Eliiiiiiiiiiii/Growlight-controller/Controller.pdf

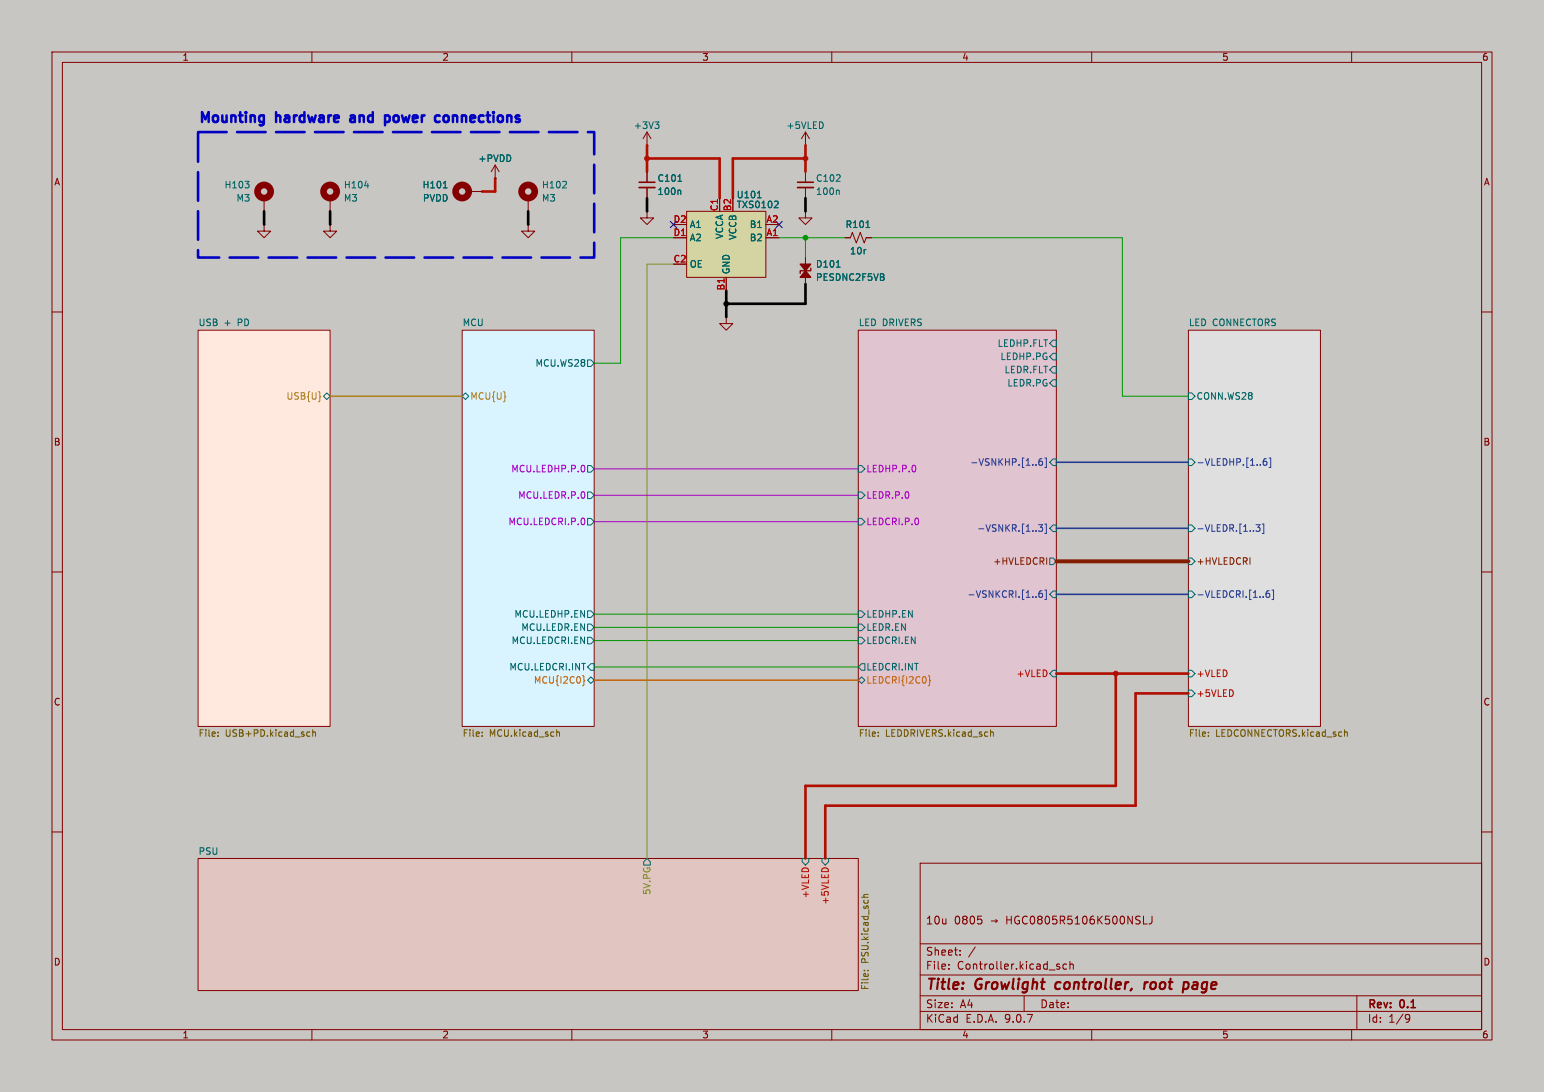
[picture p1: page 1]

100n H101 PVDD Mounting hardware and power connections

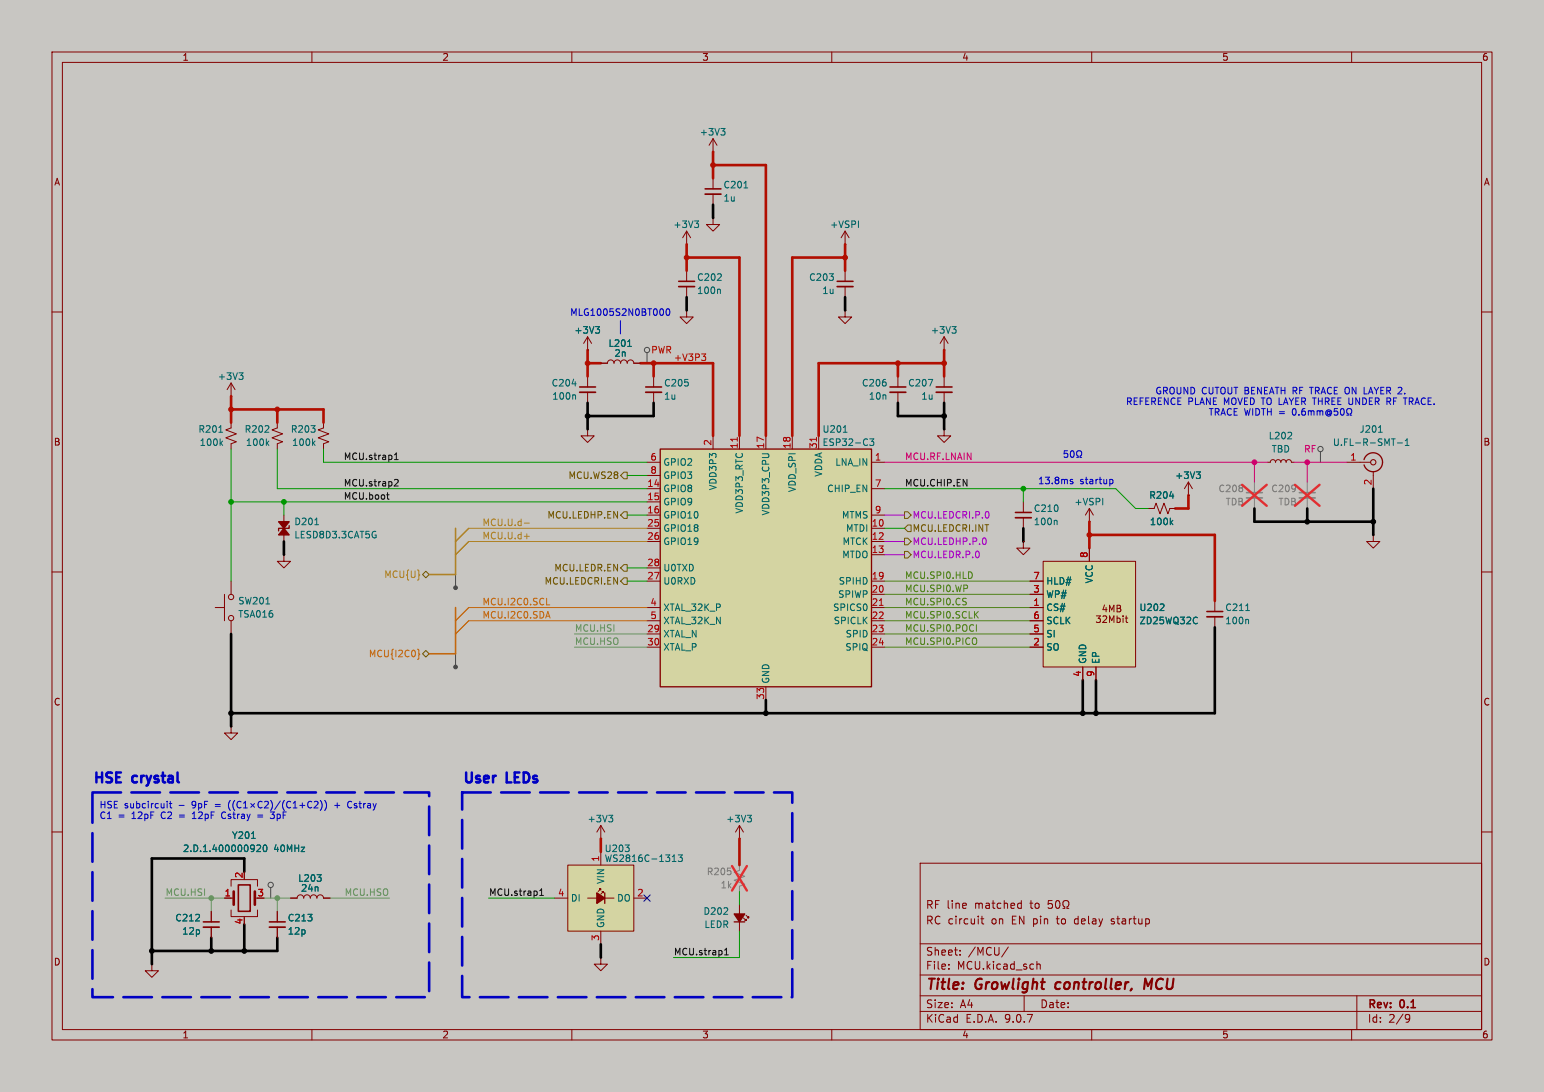
[picture p2: page 2]

8 HLD# 7 WP# 3 SI 5 SO 2 EP

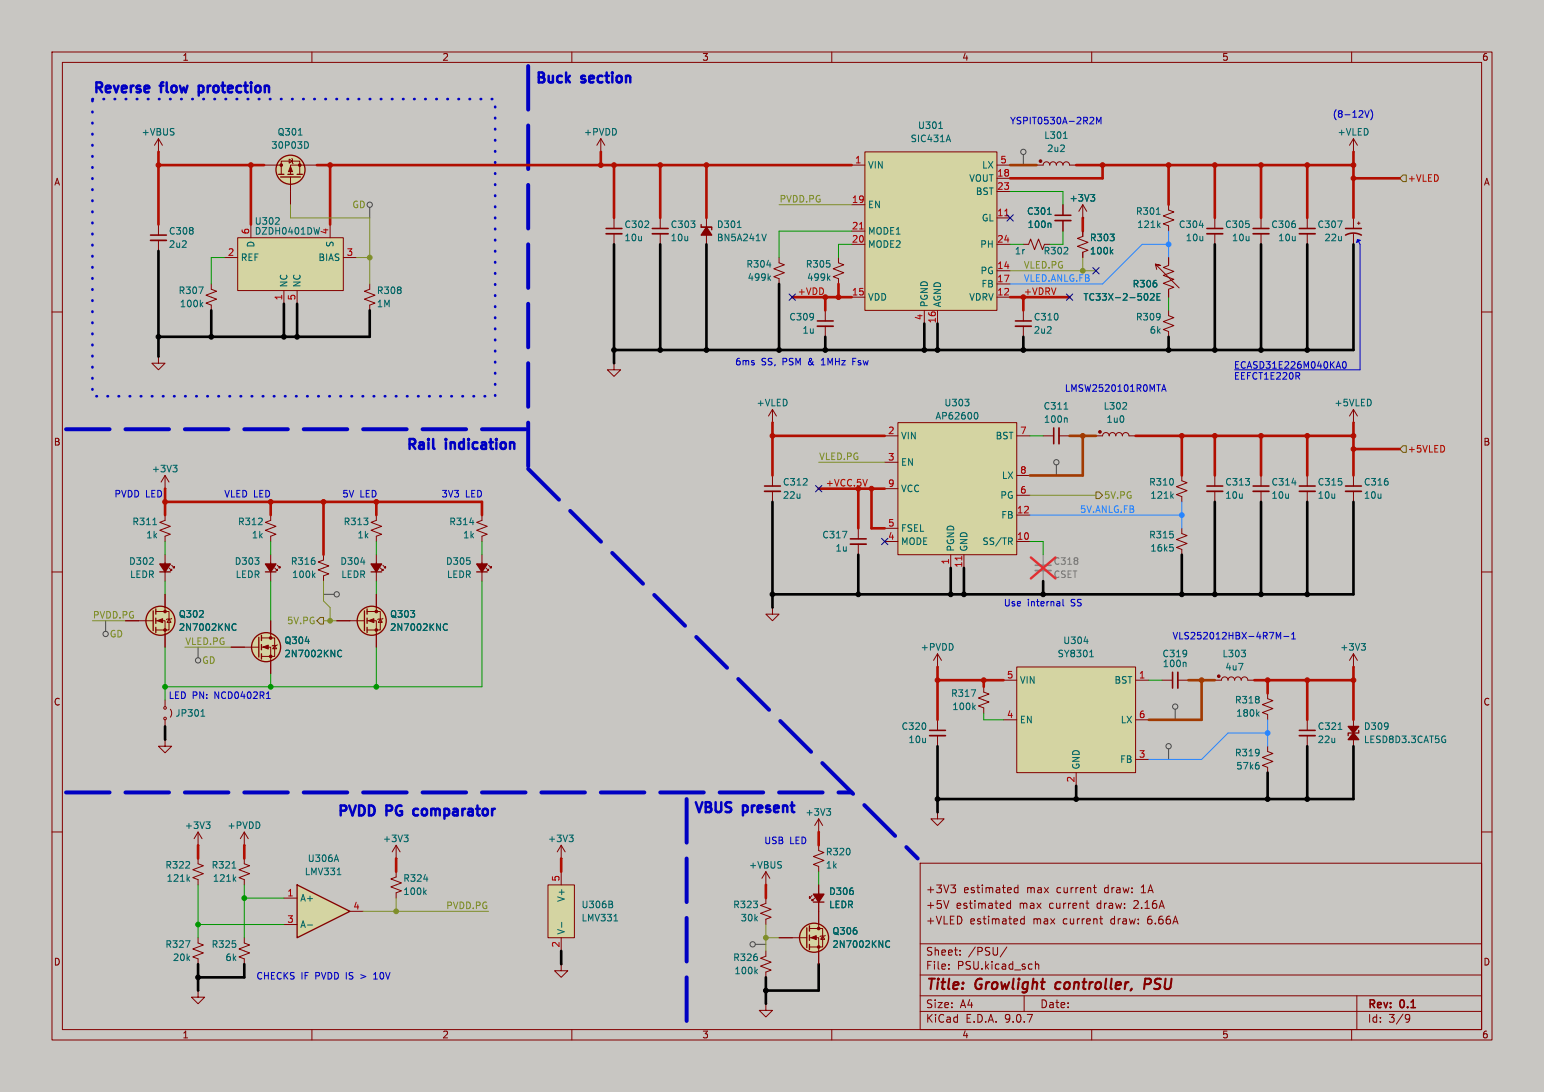
[picture p3: page 3]

LX 5 VOUT 18 BST 23 GL 11 PH 24 PG 14 FB 17 VDRV 12 U301 SIC431A R305

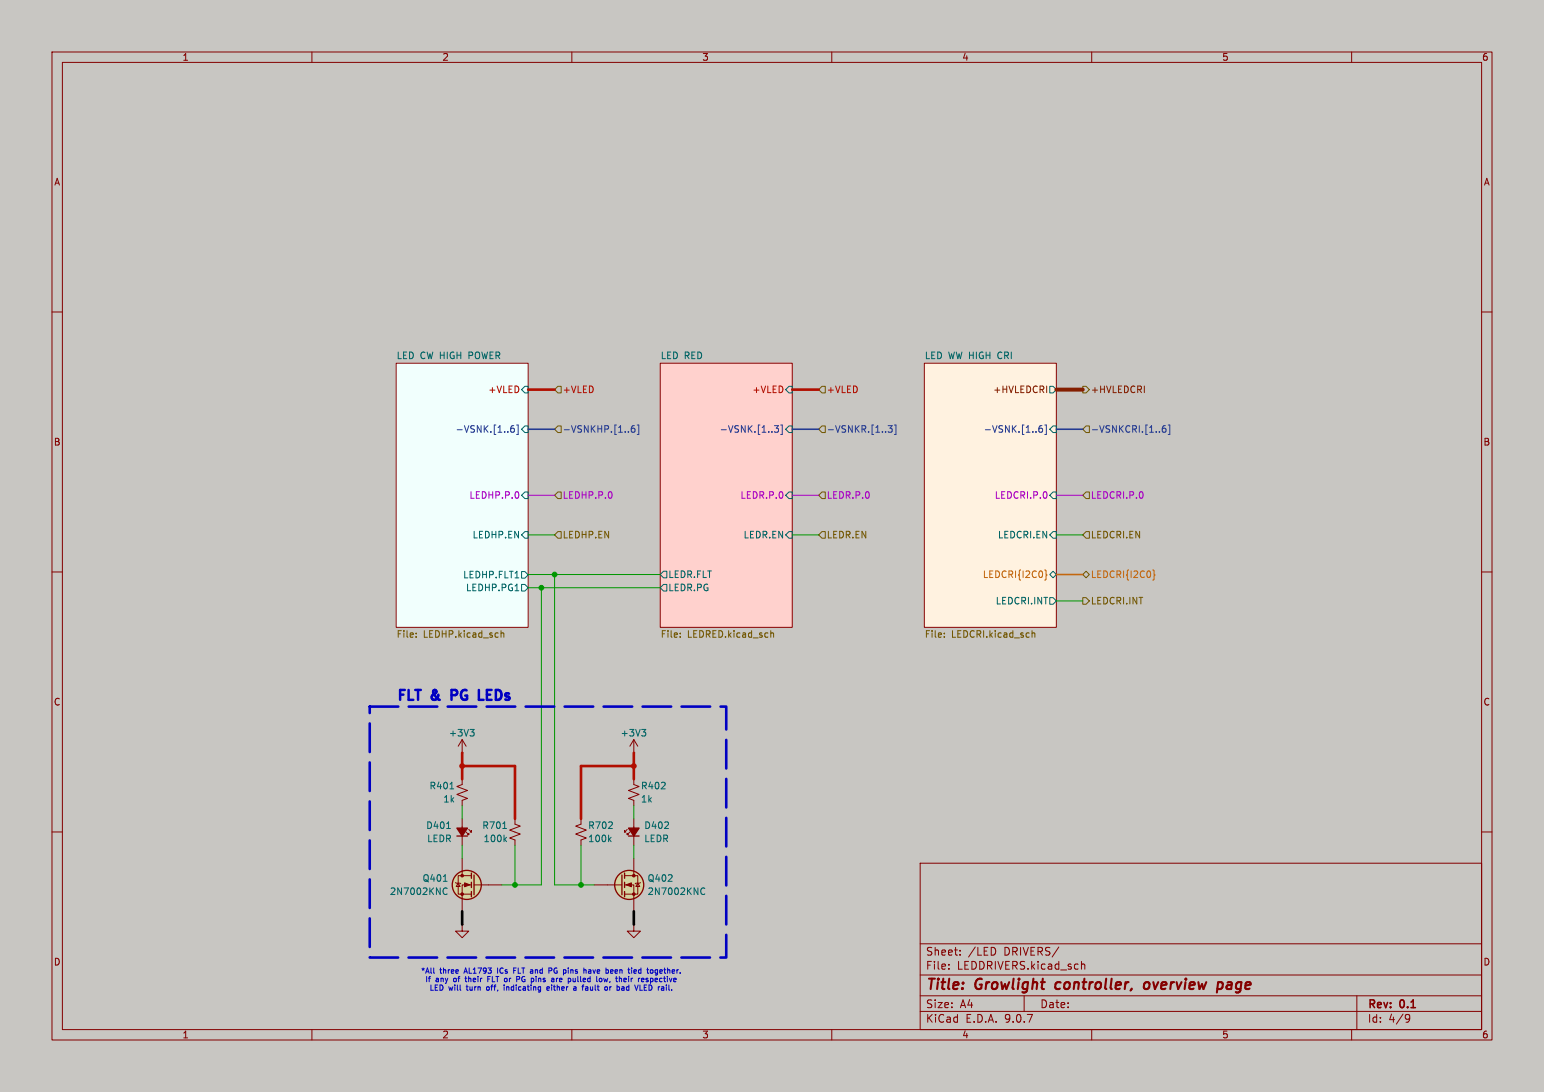
[picture p4: page 4]

LED CW HIGH POWER

LED WW HIGH CRI File: LEDCRI.kicad_sch R701

LEDCRI{I2C0} +HVLEDCRI -VSNK.[1..6] LEDCRI.P.0

*All three AL1793 ICs FLT and PG pins have been tied together.
If any of their FLT or PG pins are pulled low, their respective

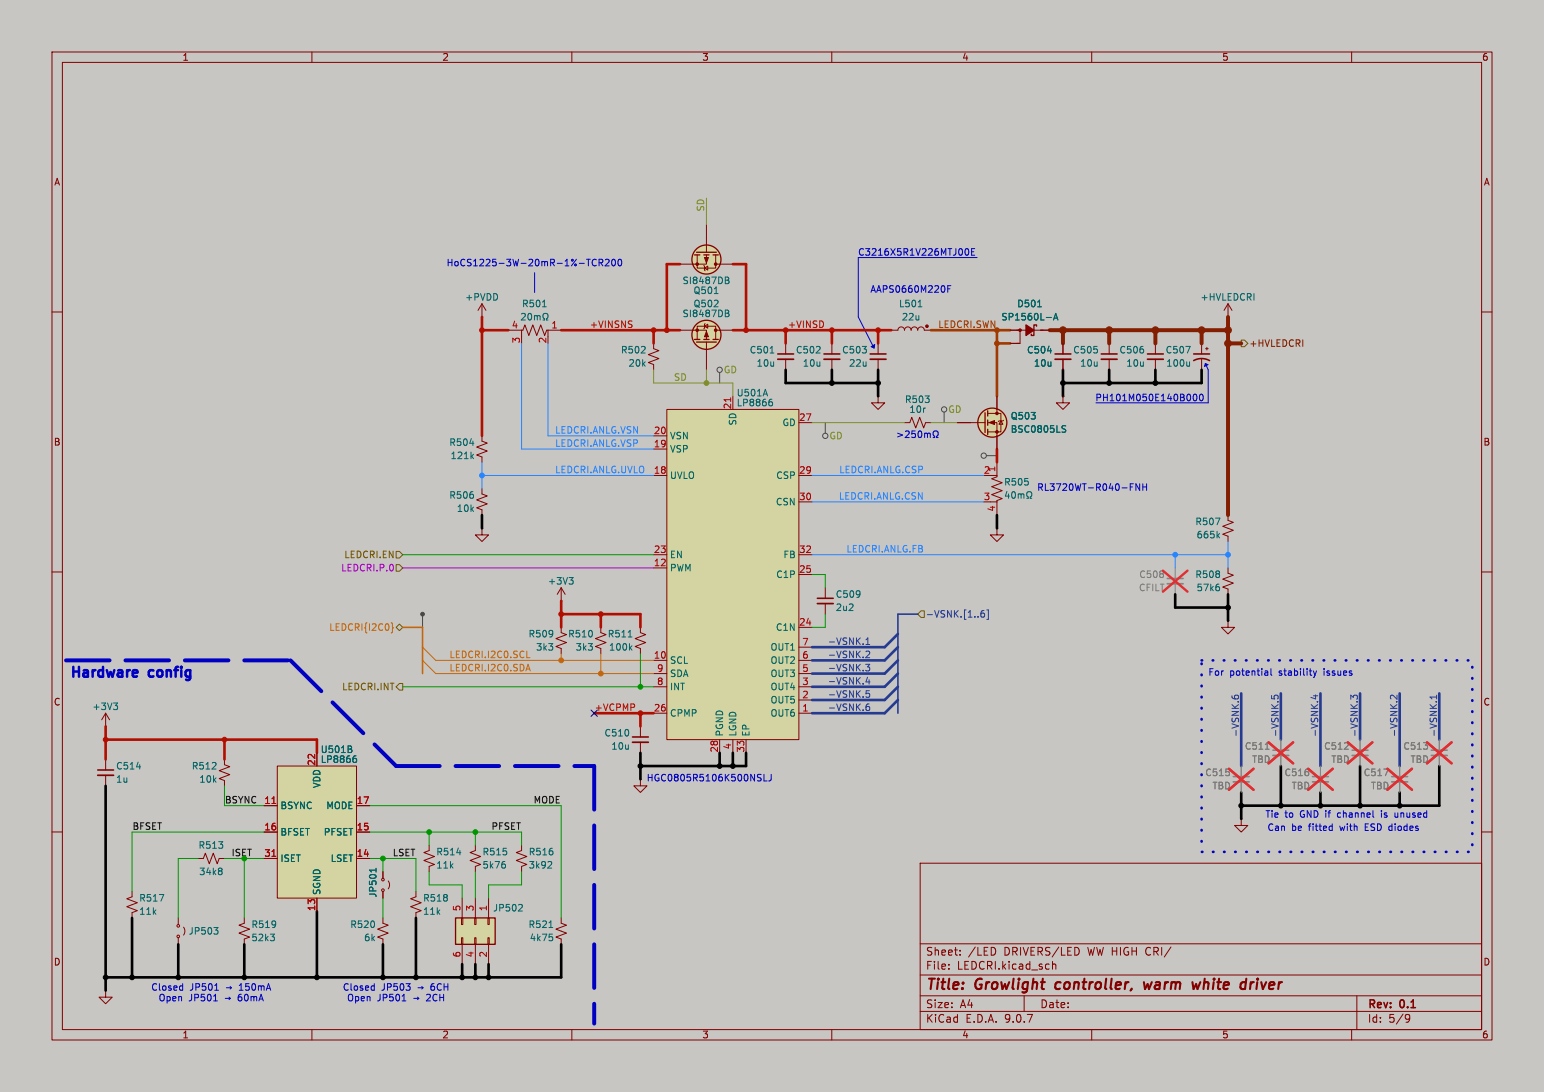
[picture p5: page 5]

4 EP 33 GD 27 CSP 29 CSN 30 FB 32 C1P 25 C1N 24 OUT1 7 OUT2 6 OUT3 5 OUT4 3 OUT5 2 OUT6 1 U501A

Closed JP501 þÿ!’150mA Open JP501 þÿ!’60mA Hardware config

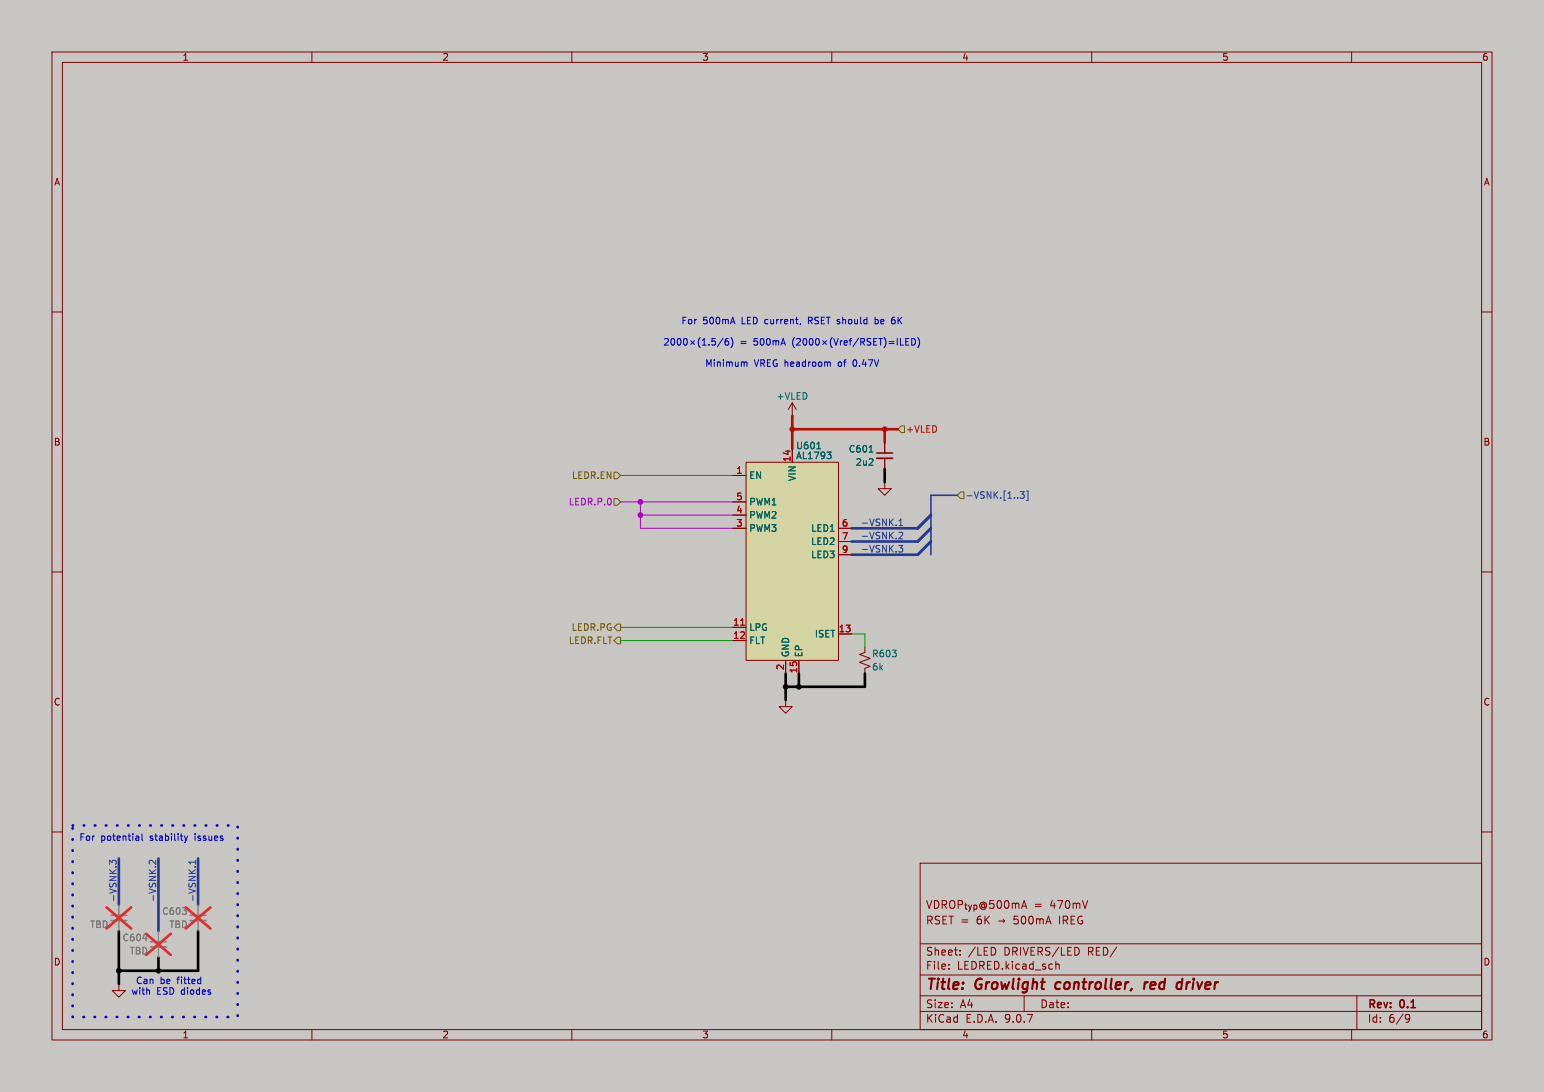
[picture p6: page 6]

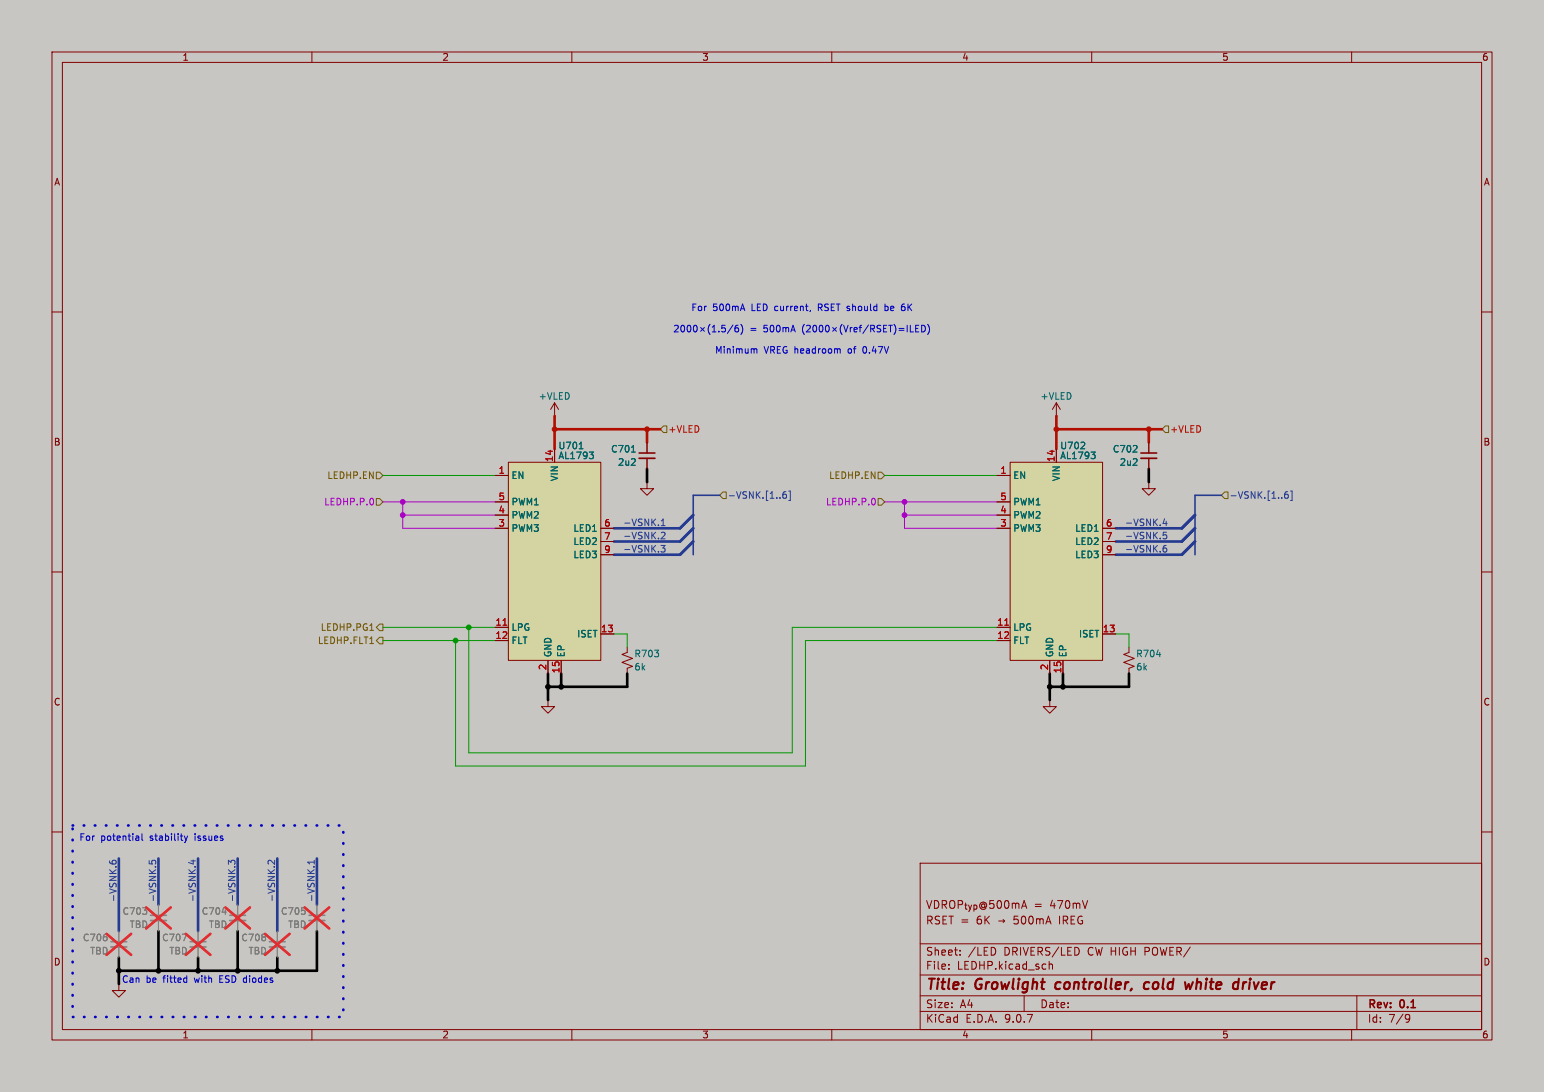
[picture p7: page 7]

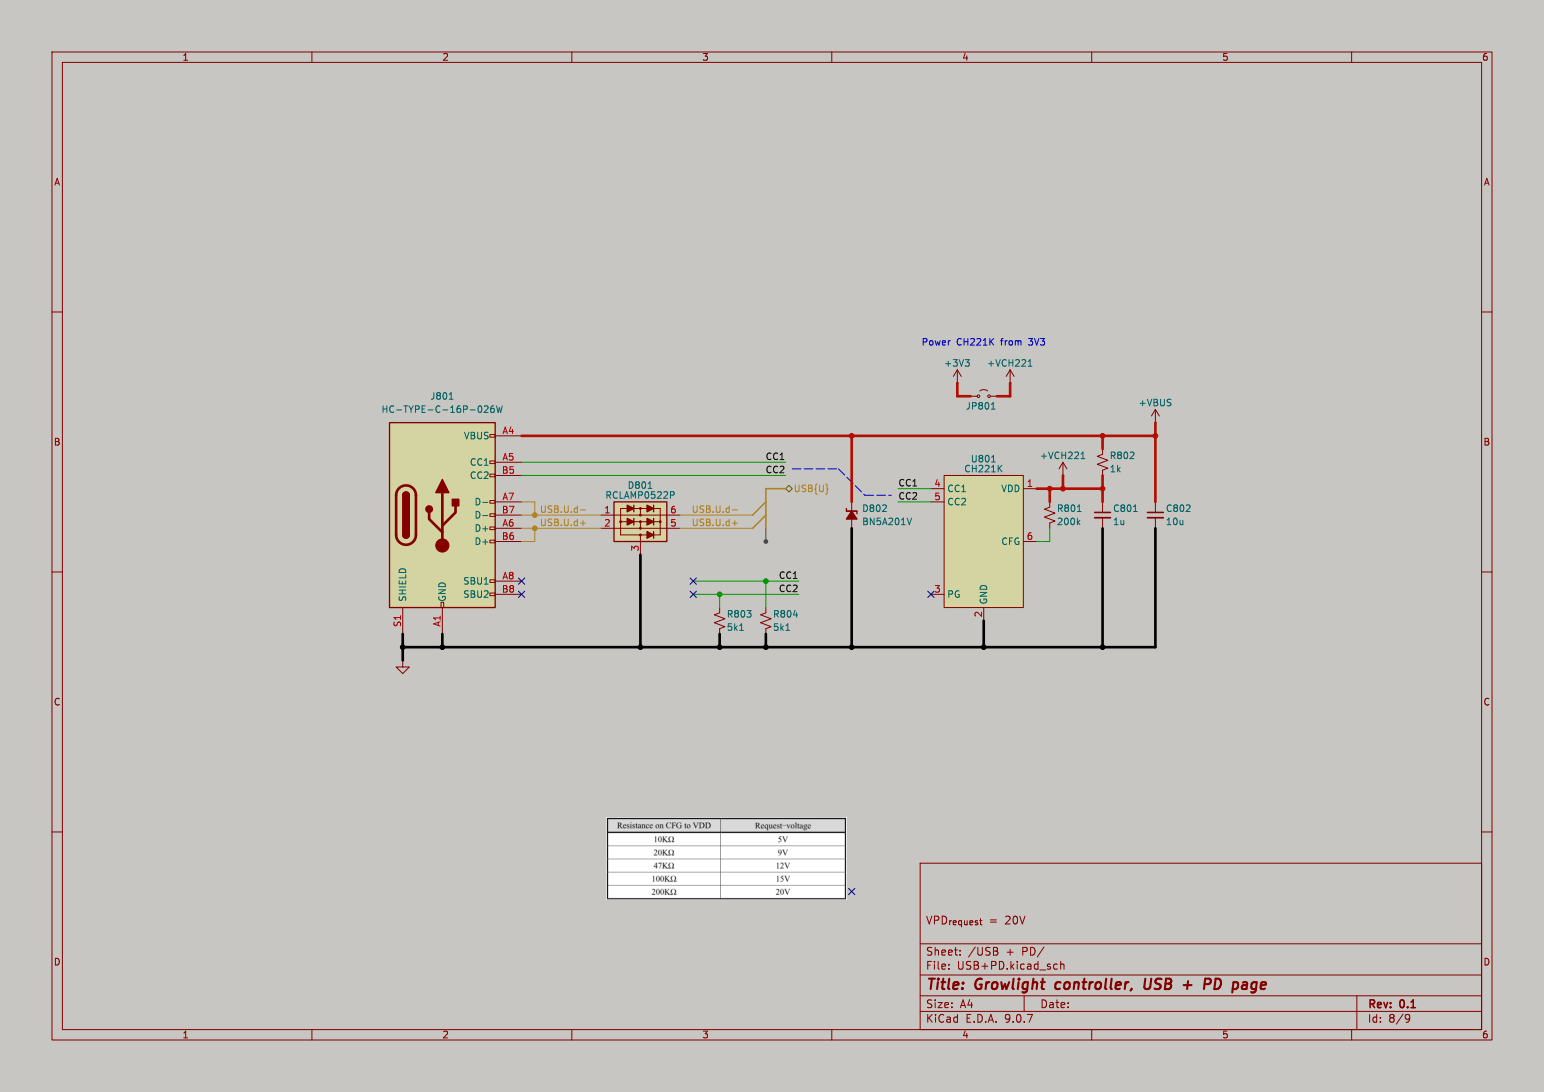
[picture p8: page 8]

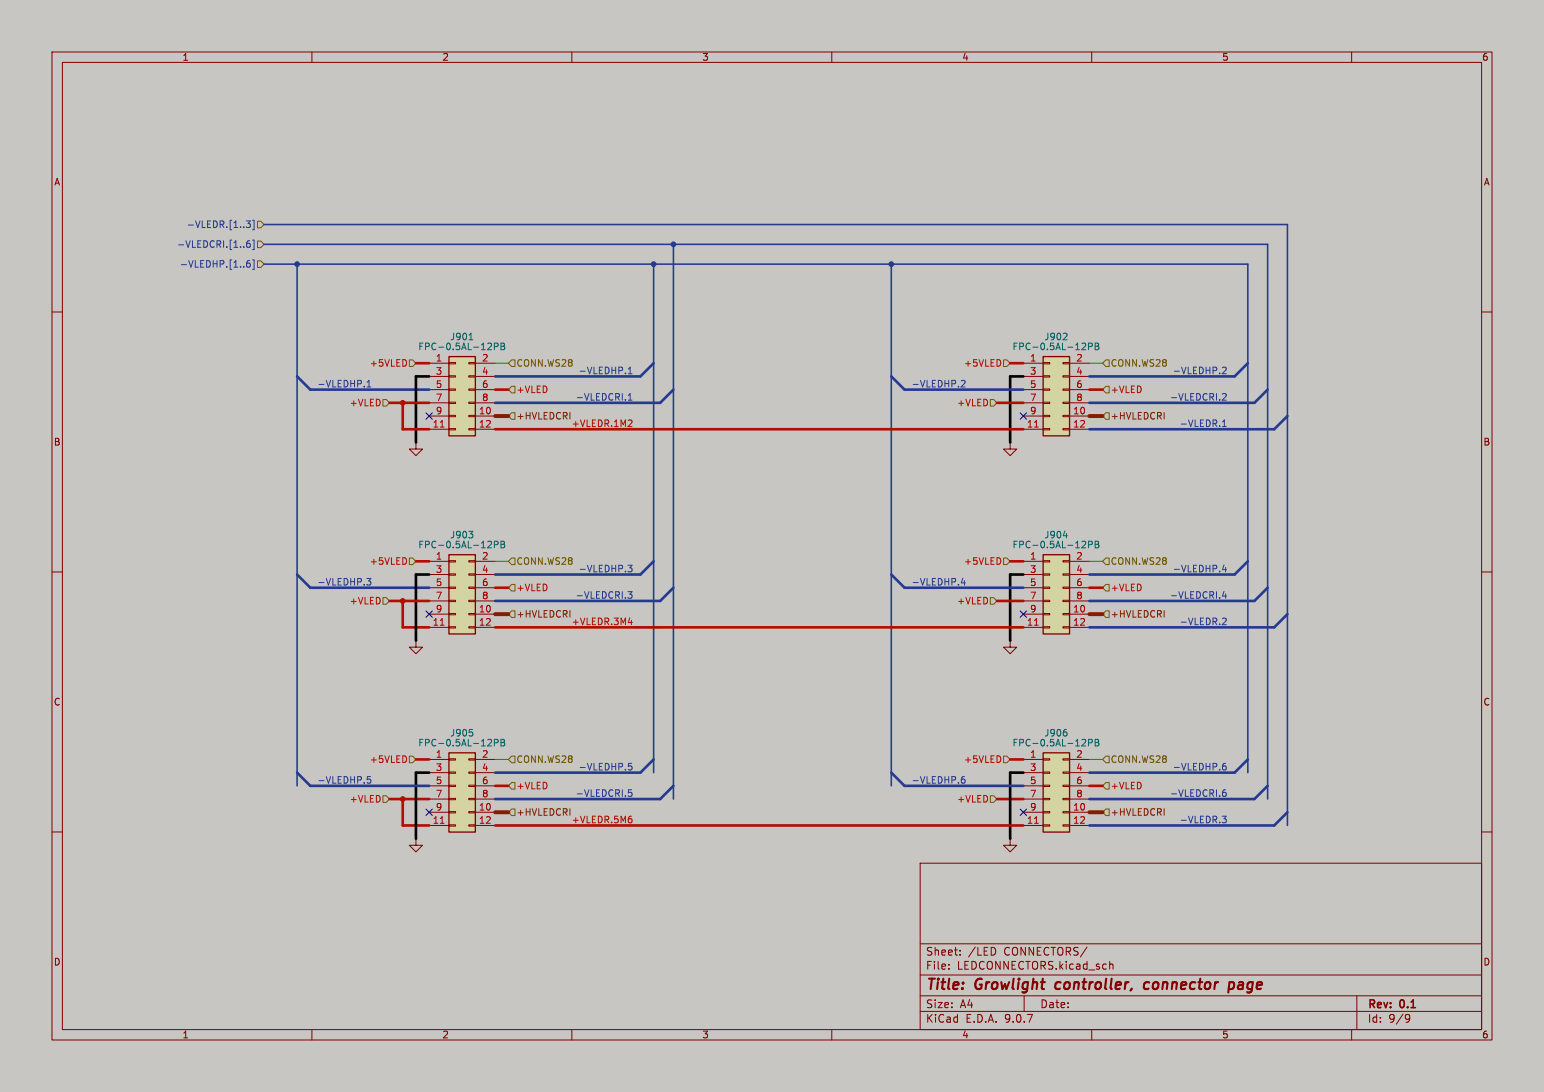
[picture p9: page 9]

File: LEDCONNECTORS.kicad_sch Sheet: /LED CONNECTORS/ 1
