Eliiiiiiiiiiii/Growlight-controller/Controller.kicad_pcb

## KiCad design Controller.kicad_pcb (2026-03-26)

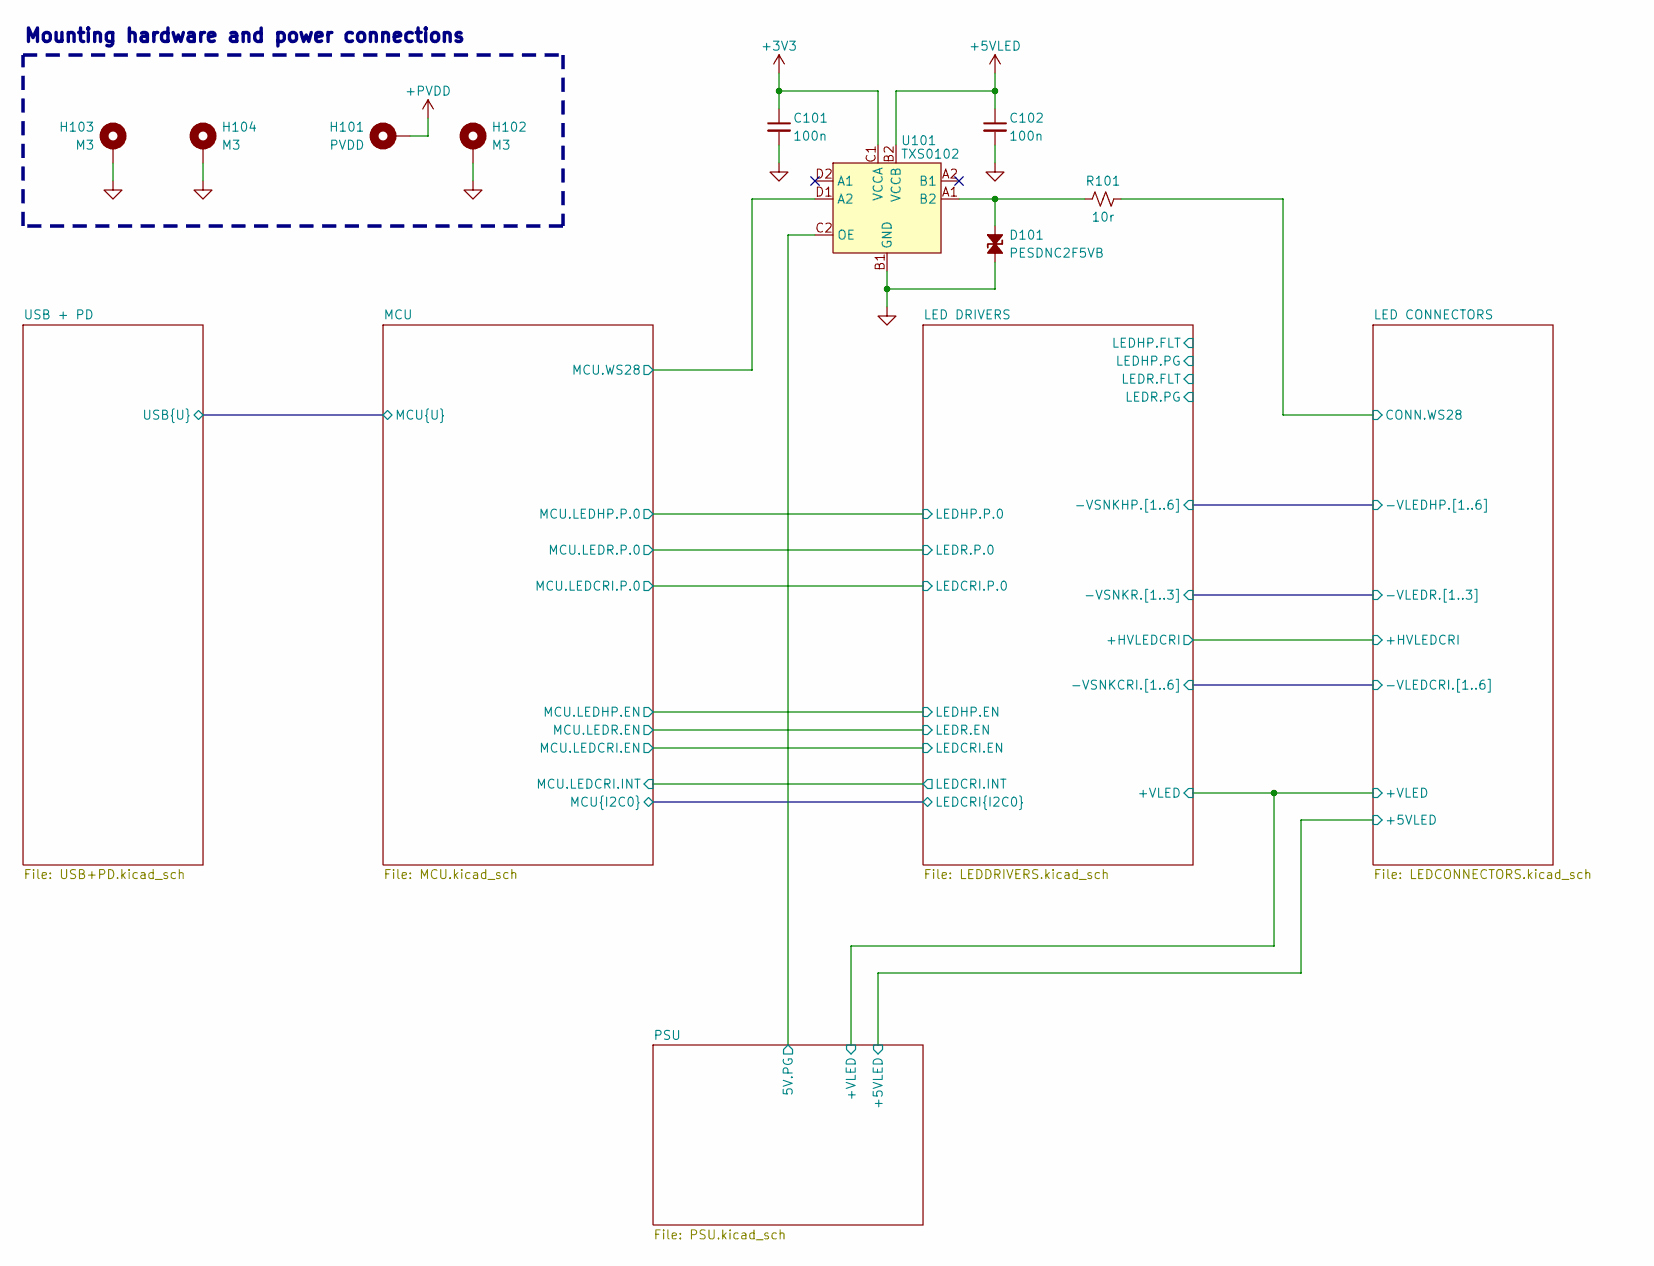
[picture p10: schematic Controller.kicad_sch, Growlight controller, root page]

Parts:
C101, C102: 100n; C 0402 (1005 Metric)
D101: PESDNC2F5VB; DFN-1006-2L
H101: PVDD; SMTSO3015CTJ
H102, H103, H104: M3; SMTSO3015CTJ
R101: 10r; R 0402 (1005 Metric)
U101: TXS0102; DSBGA-8 (0.9x1.9) P0.5

Connections:
+3V3: C101.1, U101.C1 (VCCA); also elsewhere on the board
+5VLED: C102.1, U101.B2 (VCCB); also elsewhere on the board
+PVDD: H101.1 (1_1); also elsewhere on the board
/LED CONNECTORS/CONN.WS28: R101.2; also elsewhere on the board
/MCU/MCU.WS28: U101.D1 (A2); also elsewhere on the board
/PSU/5V.PG: U101.C2 (OE); also elsewhere on the board
GND: C101.2, C102.2, D101.2 (A2), H102.1 (1_1), H103.1 (1_1), H104.1 (1_1), U101.B1 (GND); also elsewhere on the board
unnamed: D101.1 (A1), R101.1, U101.A1 (B2)

Notes on the sheet:
Mounting hardware and power connections

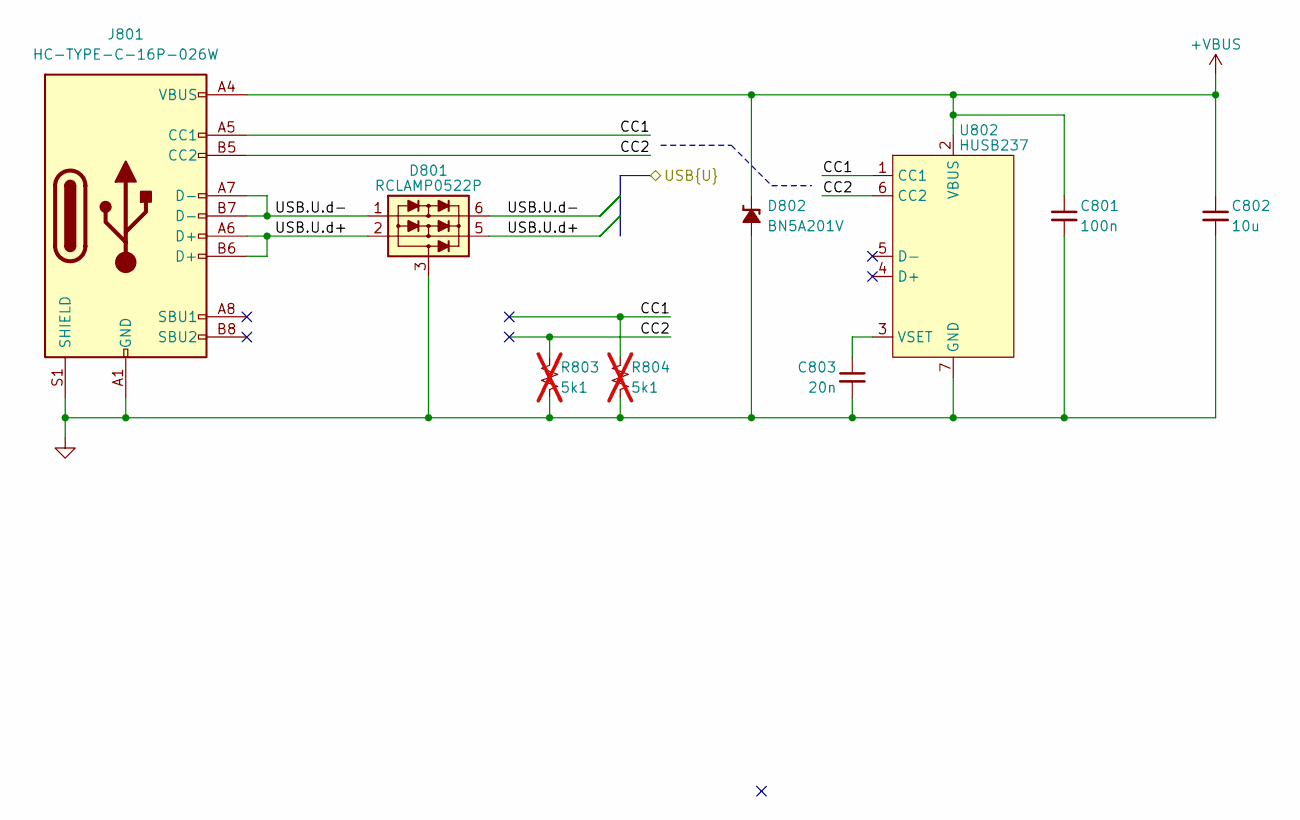
[picture p11: schematic USB+PD.kicad_sch, Growlight controller, USB + PD page]

Parts:
C801: 100n; C 0402 (1005 Metric)
C802: 10u; C 0805 (2012 Metric)
C803: 20n; C 0402 (1005 Metric)
D801: RCLAMP0522P; DFN1610-6L (1.6x1)
D802: BN5A201V; DFN1610-2L (1.6x1)
J801: HC-TYPE-C-16P-026W
R803, R804: 5k1; R 0402 (1005 Metric); not fitted
U802: HUSB237; SON-6 (2x2) P0.65

Connections:
+VBUS: C801.1, C802.1, D802.1 (K), J801.A4 (VBUS), J801.A9 (VBUS), J801.B4 (VBUS), J801.B9 (VBUS), U802.2 (VBUS); also elsewhere on the board
/MCU/MCU.U.d+: D801.2, D801.5, J801.A6 (D+), J801.B6 (D+); also elsewhere on the board
/MCU/MCU.U.d-: D801.1, D801.6, J801.A7 (D-), J801.B7 (D-); also elsewhere on the board
/USB + PD/CC1: J801.A5 (CC1), R804.1, U802.1 (CC1)
/USB + PD/CC2: J801.B5 (CC2), R803.1, U802.6 (CC2)
GND: C801.2, C802.2, C803.2, D801.3, D801.4, D802.2 (A), J801.A1 (GND), J801.A12 (GND), J801.B1 (GND), J801.B12 (GND), J801.S1 (SHIELD), R803.2, R804.2, U802.7 (GND); also elsewhere on the board
unnamed: C803.1, U802.3 (VSET)

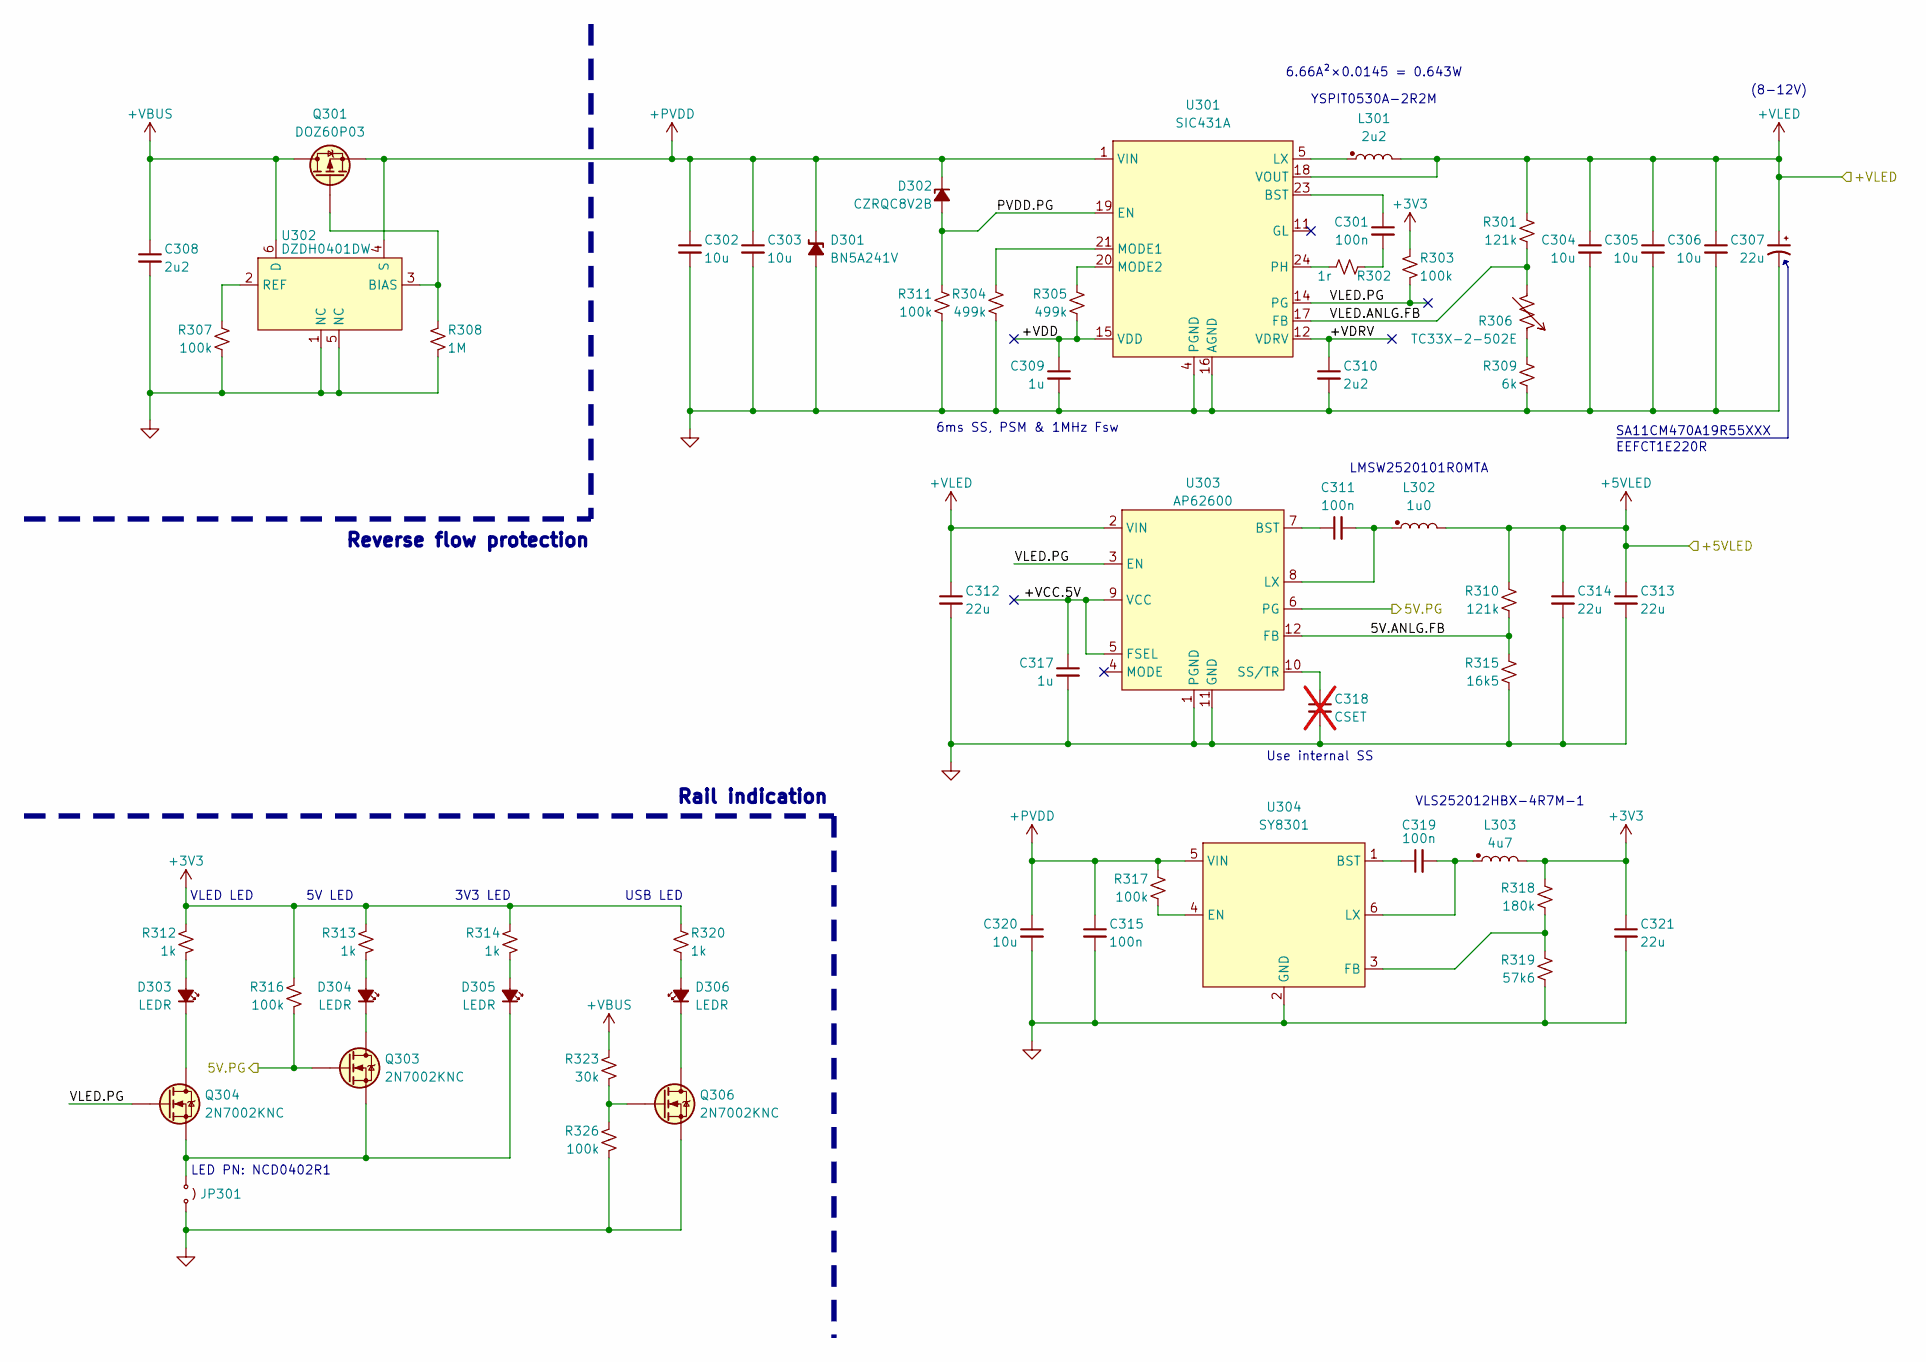
[picture p12: schematic PSU.kicad_sch, Growlight controller, PSU]

Parts:
C301, C311, C315, C319: 100n; C 0402 (1005 Metric)
C302, C303, C304, C305, C306, C320: 10u; C 0805 (2012 Metric)
C307: 22u; CP Flat (7.3x4.3) H1.4 muRata
C308, C310: 2u2; C 0603 (1608 Metric)
C309, C317: 1u; C 0402 (1005 Metric)
C312, C313, C314, C321: 22u; C 0805 (2012 Metric)
C318: CSET; C 0402 (1005 Metric); not fitted
D301: BN5A241V; DFN1610-2L (1.6x1)
D302: CZRQC8V2B; DFN-1006-2L
D303, D304, D305, D306: LEDR; LED-0402-R
JP301: Jumper_2_Small_Open; Jumper-NO 2P (1.9x1.4)
L301: 2u2; YSPIT0530A
L302: 1u0; LMSW252010
L303: 4u7; VLS252012
Q301: DOZ60P03; DFN-8 (3x3) 1EP
Q303, Q304, Q306: 2N7002KNC; DFN-1006-3L
R301, R310: 121k; R 0402 (1005 Metric)
R302: 1r; R 0402 (1005 Metric)
R303, R307, R311, R316, R317, R326: 100k; R 0402 (1005 Metric)
R304, R305: 499k; R 0402 (1005 Metric)
R306: TC33X-2-502E; TC33X-x-xxxx
R308: 1M; R 0402 (1005 Metric)
R309: 6k; R 0402 (1005 Metric)
R312, R313, R314, R320: 1k; R 0402 (1005 Metric)
R315: 16k5; R 0402 (1005 Metric)
R318: 180k; R 0402 (1005 Metric)
R319: 57k6; R 0402 (1005 Metric)
R323: 30k; R 0402 (1005 Metric)
U301: SIC431A; MLP44-24L (4x4) P0.45 Vishay
U302: DZDH0401DW; SOT-363
U303: AP62600; VQFN2030-12 (2x3) P0.5 DIODES
U304: SY8301; SOT-23-6

Connections:
+3V3: C321.1, L303.2, R303.1, R312.2, R313.2, R314.2, R316.2, R318.1, R320.2; also elsewhere on the board
+5VLED: C313.1, C314.1, L302.2, R310.1; also elsewhere on the board
+PVDD: C302.1, C303.1, C315.1, C320.1, D301.1 (K), D302.1 (K), Q301.1 (S), Q301.2 (S), Q301.3 (S), R317.1, U301.1 (VIN), U301.2 (VIN), U301.22 (VIN), U301.26 (VIN), U302.4 (S), U304.5 (VIN); also elsewhere on the board
+VBUS: C308.1, Q301.5 (D), R323.2, U302.6 (D); also elsewhere on the board
+VLED: C304.1, C305.1, C306.1, C307.1, C312.1, L301.2, R301.1, U301.18 (VOUT), U303.2 (VIN); also elsewhere on the board
/PSU/5V.ANLG.FB: R310.2, R315.1, U303.12 (FB)
/PSU/5V.PG: Q303.1 (G), R316.1, U303.6 (PG); also elsewhere on the board
/PSU/+VCC.5V: C317.1, U303.5 (FSEL), U303.9 (VCC)
/PSU/+VDD: C309.1, R305.2, U301.15 (VDD)
/PSU/+VDRV: C310.1, U301.12 (VDRV)
/PSU/PVDD.PG: D302.2 (A), R311.1, U301.19 (EN)
/PSU/VLED.ANLG.FB: R301.2, R306.2, U301.17 (FB)
/PSU/VLED.PG: Q304.1 (G), R303.2, U301.14 (PG), U303.3 (EN)
GND: C302.2, C303.2, C304.2, C305.2, C306.2, C307.2, C308.2, C309.2, C310.2, C312.2, C313.2, C314.2, C315.2, C317.2, C318.2, C320.2, C321.2, D301.2 (A), JP301.1 (A), Q306.2 (S), R304.2, R307.2, R308.2, R309.2, R311.2, R315.2, R319.2, R326.1, U301.3 (PGND), U301.4 (PGND), U301.13 (PGND), U301.16 (AGND), U301.25 (AGND), U301.27 (PGND), U302.1 (NC), U302.5 (NC), U303.1 (PGND), U303.11 (GND), U304.2 (GND); also elsewhere on the board
unnamed: C301.2, R302.2
unnamed: D303.2 (A), R312.1
unnamed: D303.1 (K), Q304.3 (D)
unnamed: D304.2 (A), R313.1
unnamed: D304.1 (K), Q303.3 (D)
unnamed: D305.2 (A), R314.1
unnamed: D305.1 (K), JP301.2 (B), Q303.2 (S), Q304.2 (S)
unnamed: D306.2 (A), R320.1
unnamed: D306.1 (K), Q306.3 (D)
unnamed: L301.1, U301.5 (LX), U301.6 (LX), U301.7 (LX), U301.8 (LX), U301.9 (LX)
unnamed: Q301.4 (G), R308.1, U302.3 (BIAS)
unnamed: Q306.1 (G), R323.1, R326.2
unnamed: R306.1, R309.1
unnamed: C301.1, U301.23 (BST)
unnamed: R304.1, U301.21 (MODE1)
unnamed: R305.1, U301.20 (MODE2)
unnamed: R302.1, U301.24 (PH)
unnamed: R307.1, U302.2 (REF)
unnamed: C311.1, U303.7 (BST)
unnamed: C311.2, L302.1, U303.8 (LX)
unnamed: C318.1, U303.10 (SS/TR)
unnamed: C319.1, U304.1 (BST)
unnamed: R317.2, U304.4 (EN)
unnamed: R318.2, R319.1, U304.3 (FB)
unnamed: C319.2, L303.1, U304.6 (LX)

Notes on the sheet:
5V LED
Reverse flow protection
VLS252012HBX-4R7M-1
LED PN: NCD0402R1
USB LED
3V3 LED
EEFCT1E220R
(8-12V)
Rail indication
YSPIT0530A-2R2M
SA11CM470A19R55XXX
VLED LED
LMSW2520101R0MTA
6.66A²×0.0145 = 0.643W
6ms SS, PSM & 1MHz Fsw
Use internal SS

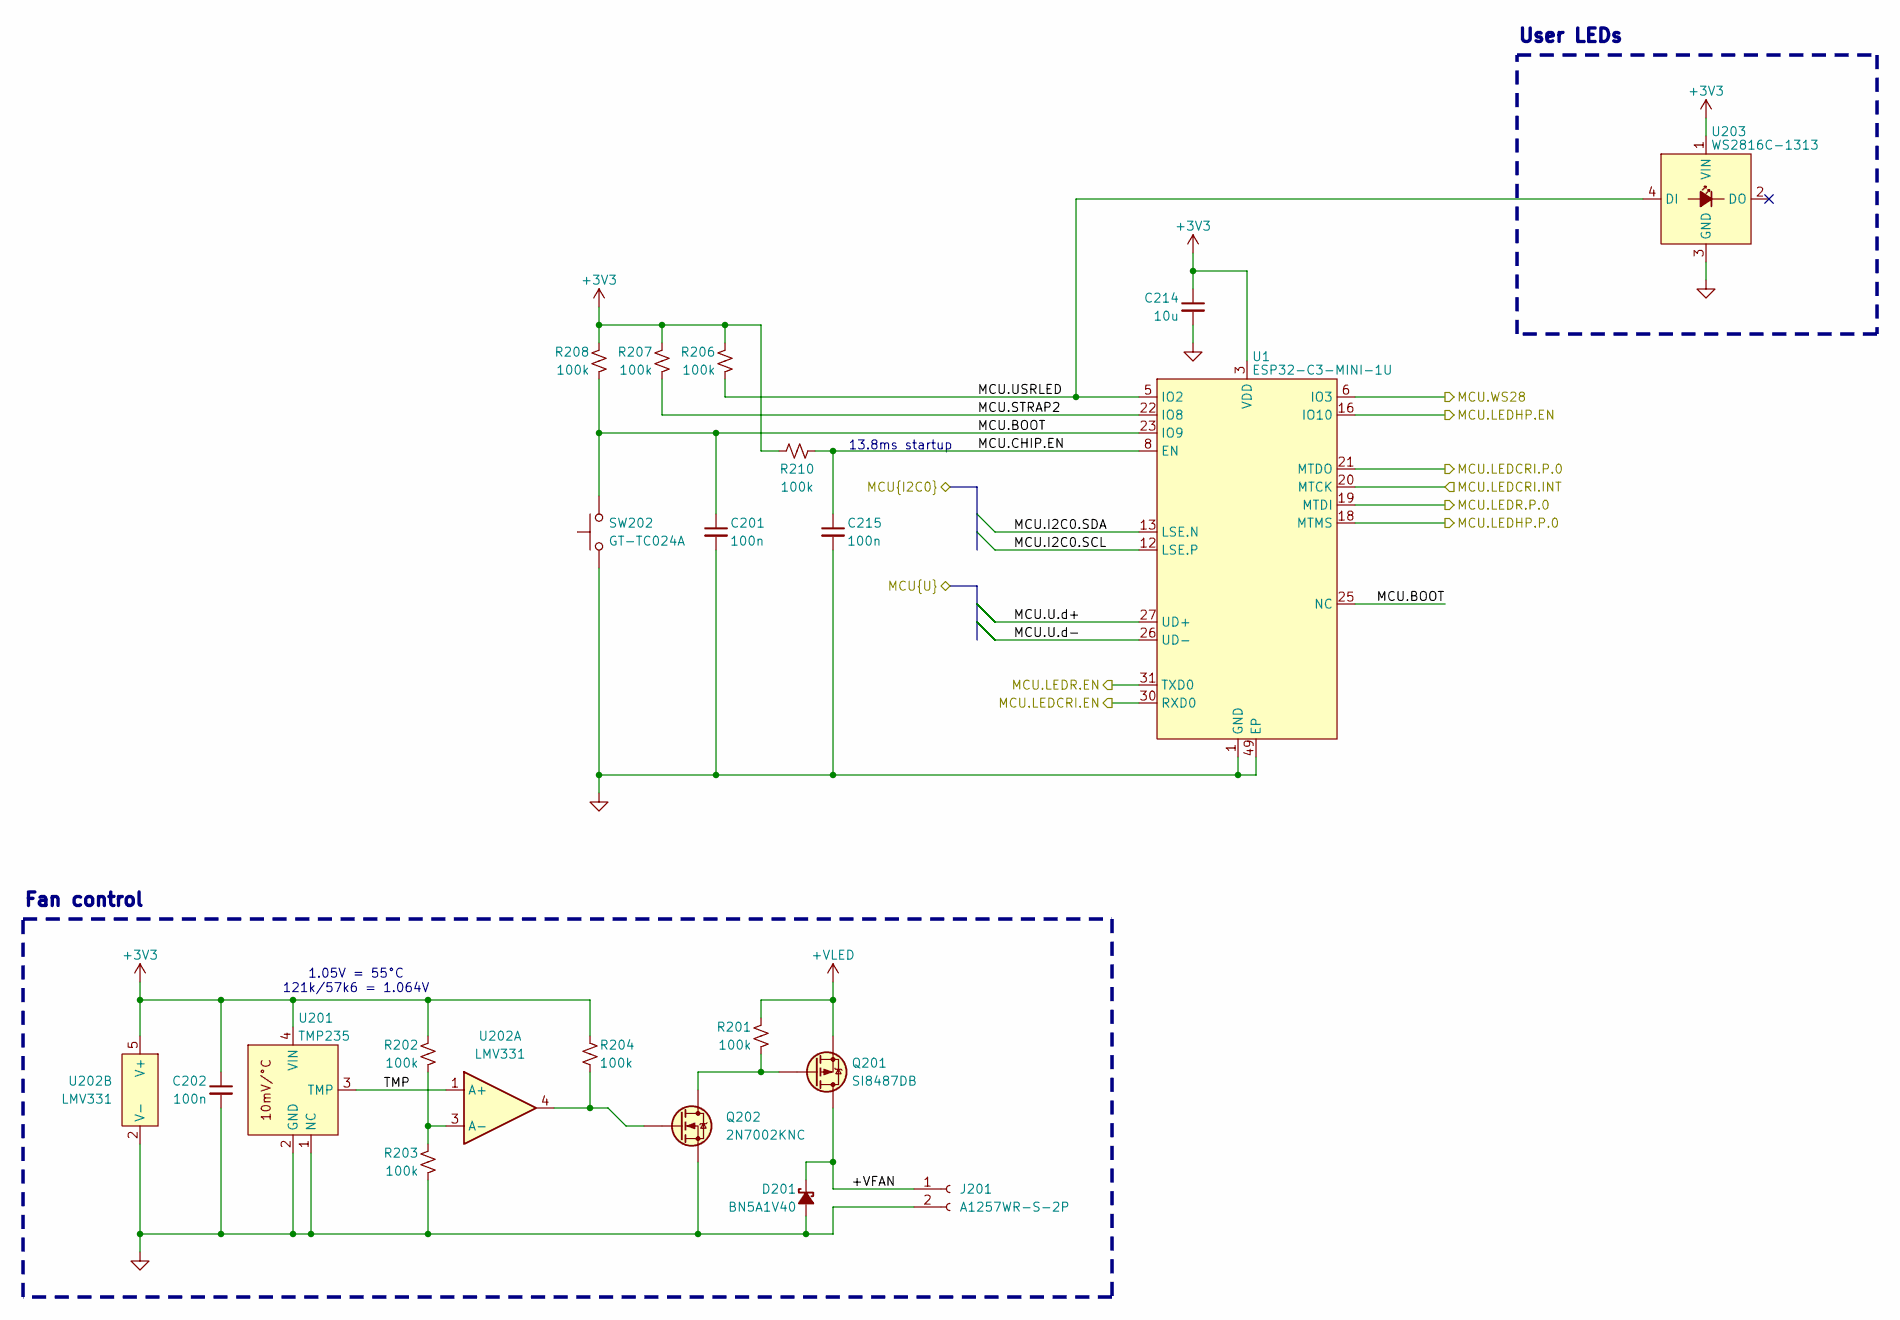
[picture p13: schematic MCU.kicad_sch, Growlight controller, MCU]

Parts:
C201, C202, C215: 100n; C 0402 (1005 Metric)
C214: 10u; C 0805 (2012 Metric)
D201: BN5A1V40; DFN1610-2L (1.6x1)
J201: A1257WR-S-2P; A1257WR-S-2P (GH)
Q201: SI8487DB; WLCSP-4 (1.56x1.56) P0.8
Q202: 2N7002KNC; DFN-1006-3L
R201, R202, R203, R204, R206, R207, R208, R210: 100k; R 0402 (1005 Metric)
SW202: GT-TC024A; GT-TC024A-H0060-L1
U1: ESP32-C3-MINI-1U
U201: TMP235; SOT-363-5
U202: LMV331; SOT-363-5
U203: WS2816C-1313; WS2816C-1313 4P

Connections:
+3V3: C202.1, C214.1, R202.2, R204.2, R206.2, R207.2, R208.2, R210.1, U1.3 (VDD), U201.4 (VIN), U202.5 (V+), U203.1 (VIN); also elsewhere on the board
+VLED: Q201.4 (S), R201.2; also elsewhere on the board
/LED DRIVERS/LEDCRI.EN: U1.30 (RXD0); also elsewhere on the board
/LED DRIVERS/LEDCRI.I2C0.SCL: U1.12 (LSE.P); also elsewhere on the board
/LED DRIVERS/LEDCRI.I2C0.SDA: U1.13 (LSE.N); also elsewhere on the board
/LED DRIVERS/LEDCRI.INT: U1.20 (MTCK); also elsewhere on the board
/LED DRIVERS/LEDCRI.P.0: U1.21 (MTDO); also elsewhere on the board
/LED DRIVERS/LEDHP.EN: U1.16 (IO10); also elsewhere on the board
/LED DRIVERS/LEDHP.P.0: U1.18 (MTMS); also elsewhere on the board
/LED DRIVERS/LEDR.EN: U1.31 (TXD0); also elsewhere on the board
/LED DRIVERS/LEDR.P.0: U1.19 (MTDI); also elsewhere on the board
/MCU/+VFAN: D201.1 (K), J201.1, Q201.2 (D), Q201.3 (D)
/MCU/MCU.BOOT: C201.1, R208.1, SW202.2, U1.23 (IO9), U1.25 (NC)
/MCU/MCU.CHIP.EN: C215.1, R210.2, U1.8 (EN)
/MCU/MCU.STRAP2: R207.1, U1.22 (IO8)
/MCU/MCU.U.d+: U1.27 (UD+); also elsewhere on the board
/MCU/MCU.U.d-: U1.26 (UD-); also elsewhere on the board
/MCU/MCU.USRLED: R206.1, U1.5 (IO2), U203.4 (DI)
/MCU/MCU.WS28: U1.6 (IO3); also elsewhere on the board
/MCU/TMP: U201.3 (TMP), U202.1 (A+)
GND: C201.2, C202.2, C214.2, C215.2, D201.2 (A), J201.2, Q202.2 (S), R203.1, SW202.1, U1.1 (GND), U1.2 (GND), U1.11 (GND), U1.14 (GND), U1.36 (GND), U1.37 (GND), U1.38 (GND), U1.39 (GND), U1.40 (GND), U1.41 (GND), U1.42 (GND), U1.43 (GND), U1.44 (GND), U1.45 (GND), U1.46 (GND), U1.47 (GND), U1.48 (GND), U1.49 (EP), U1.50 (GND), U1.51 (GND), U1.52 (GND), U1.53 (GND), U201.1 (NC), U201.2 (GND), U201.5 (NC), U202.2 (V-), U203.3 (GND); also elsewhere on the board
unnamed: Q201.1 (G), Q202.3 (D), R201.1
unnamed: Q202.1 (G), R204.1, U202.4
unnamed: R202.1, R203.2, U202.3 (A-)

Notes on the sheet:
1.05V = 55°C 121k/57k6 = 1.064V
User LEDs
13.8ms startup
Fan control

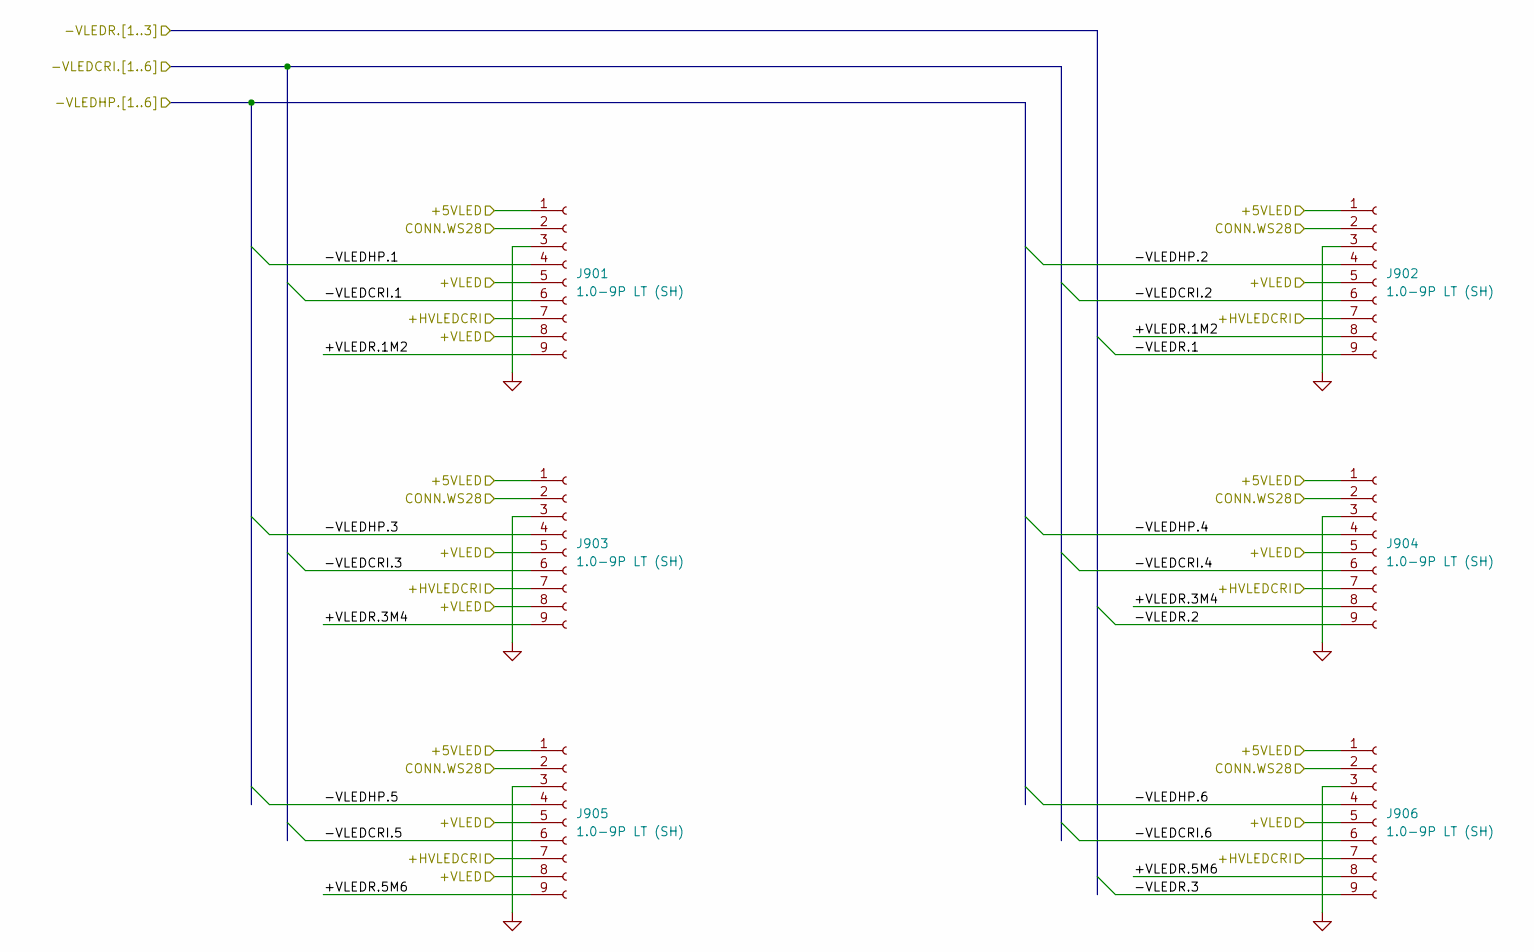
[picture p14: schematic LEDCONNECTORS.kicad_sch, Growlight controller, connector page]

Parts:
J901, J902, J903, J904, J905, J906: 1.0-9P LT (SH)

Connections:
+5VLED: J901.1, J902.1, J903.1, J904.1, J905.1, J906.1; also elsewhere on the board
+HVLEDCRI: J901.7, J902.7, J903.7, J904.7, J905.7, J906.7; also elsewhere on the board
+VLED: J901.5, J901.8, J902.5, J903.5, J903.8, J904.5, J905.5, J905.8, J906.5; also elsewhere on the board
/LED CONNECTORS/+VLEDR.1M2: J901.9, J902.8
/LED CONNECTORS/+VLEDR.3M4: J903.9, J904.8
/LED CONNECTORS/+VLEDR.5M6: J905.9, J906.8
/LED CONNECTORS/-VLEDCRI.1: J901.6; also elsewhere on the board
/LED CONNECTORS/-VLEDCRI.2: J902.6; also elsewhere on the board
/LED CONNECTORS/-VLEDCRI.3: J903.6; also elsewhere on the board
/LED CONNECTORS/-VLEDCRI.4: J904.6; also elsewhere on the board
/LED CONNECTORS/-VLEDCRI.5: J905.6; also elsewhere on the board
/LED CONNECTORS/-VLEDCRI.6: J906.6; also elsewhere on the board
/LED CONNECTORS/-VLEDHP.1: J901.4; also elsewhere on the board
/LED CONNECTORS/-VLEDHP.2: J902.4; also elsewhere on the board
/LED CONNECTORS/-VLEDHP.3: J903.4; also elsewhere on the board
/LED CONNECTORS/-VLEDHP.4: J904.4; also elsewhere on the board
/LED CONNECTORS/-VLEDHP.5: J905.4; also elsewhere on the board
/LED CONNECTORS/-VLEDHP.6: J906.4; also elsewhere on the board
/LED CONNECTORS/-VLEDR.1: J902.9; also elsewhere on the board
/LED CONNECTORS/-VLEDR.2: J904.9; also elsewhere on the board
/LED CONNECTORS/-VLEDR.3: J906.9; also elsewhere on the board
/LED CONNECTORS/CONN.WS28: J901.2, J902.2, J903.2, J904.2, J905.2, J906.2; also elsewhere on the board
GND: J901.3, J902.3, J903.3, J904.3, J905.3, J906.3; also elsewhere on the board

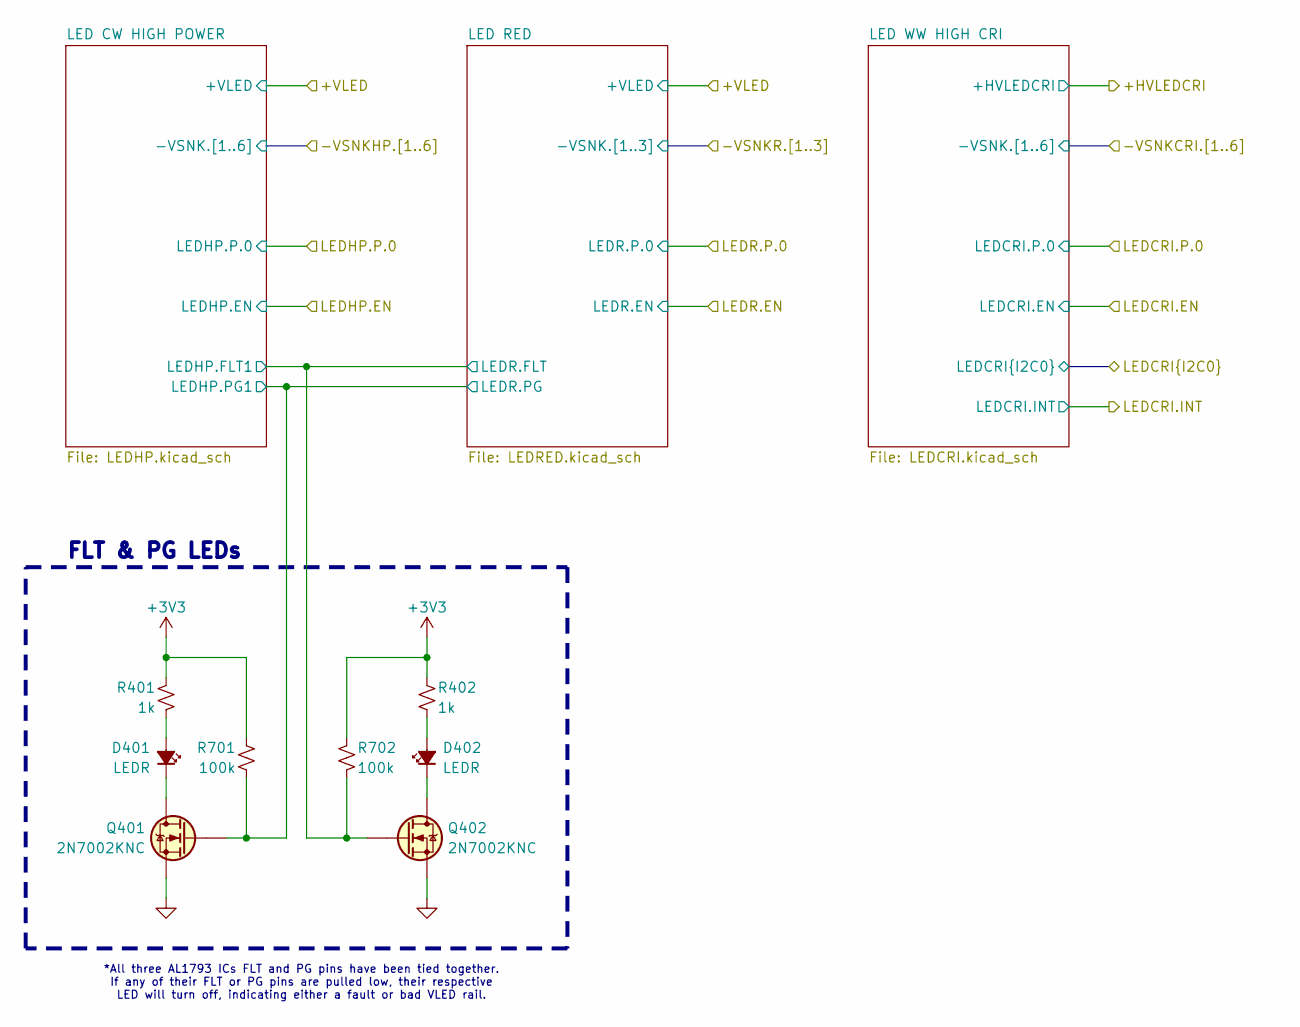
[picture p15: schematic LEDDRIVERS.kicad_sch, Growlight controller, overview page]

Parts:
D401, D402: LEDR; LED-0402-R
Q401, Q402: 2N7002KNC; DFN-1006-3L
R401, R402: 1k; R 0402 (1005 Metric)
R701, R702: 100k; R 0402 (1005 Metric)

Connections:
+3V3: R401.2, R402.2, R701.1, R702.1; also elsewhere on the board
/LED DRIVERS/LED CW HIGH POWER/LEDHP.FLT1: Q402.1 (G), R702.2; also elsewhere on the board
/LED DRIVERS/LED CW HIGH POWER/LEDHP.PG1: Q401.1 (G), R701.2; also elsewhere on the board
GND: Q401.2 (S), Q402.2 (S); also elsewhere on the board
unnamed: D401.2 (A), R401.1
unnamed: D401.1 (K), Q401.3 (D)
unnamed: D402.2 (A), R402.1
unnamed: D402.1 (K), Q402.3 (D)

Notes on the sheet:
*All three AL1793 ICs FLT and PG pins have been tied together. If any of their FLT or PG pins are pulled low, their respective LED will turn off, indicating either a fault or bad VLED rail.
FLT & PG LEDs

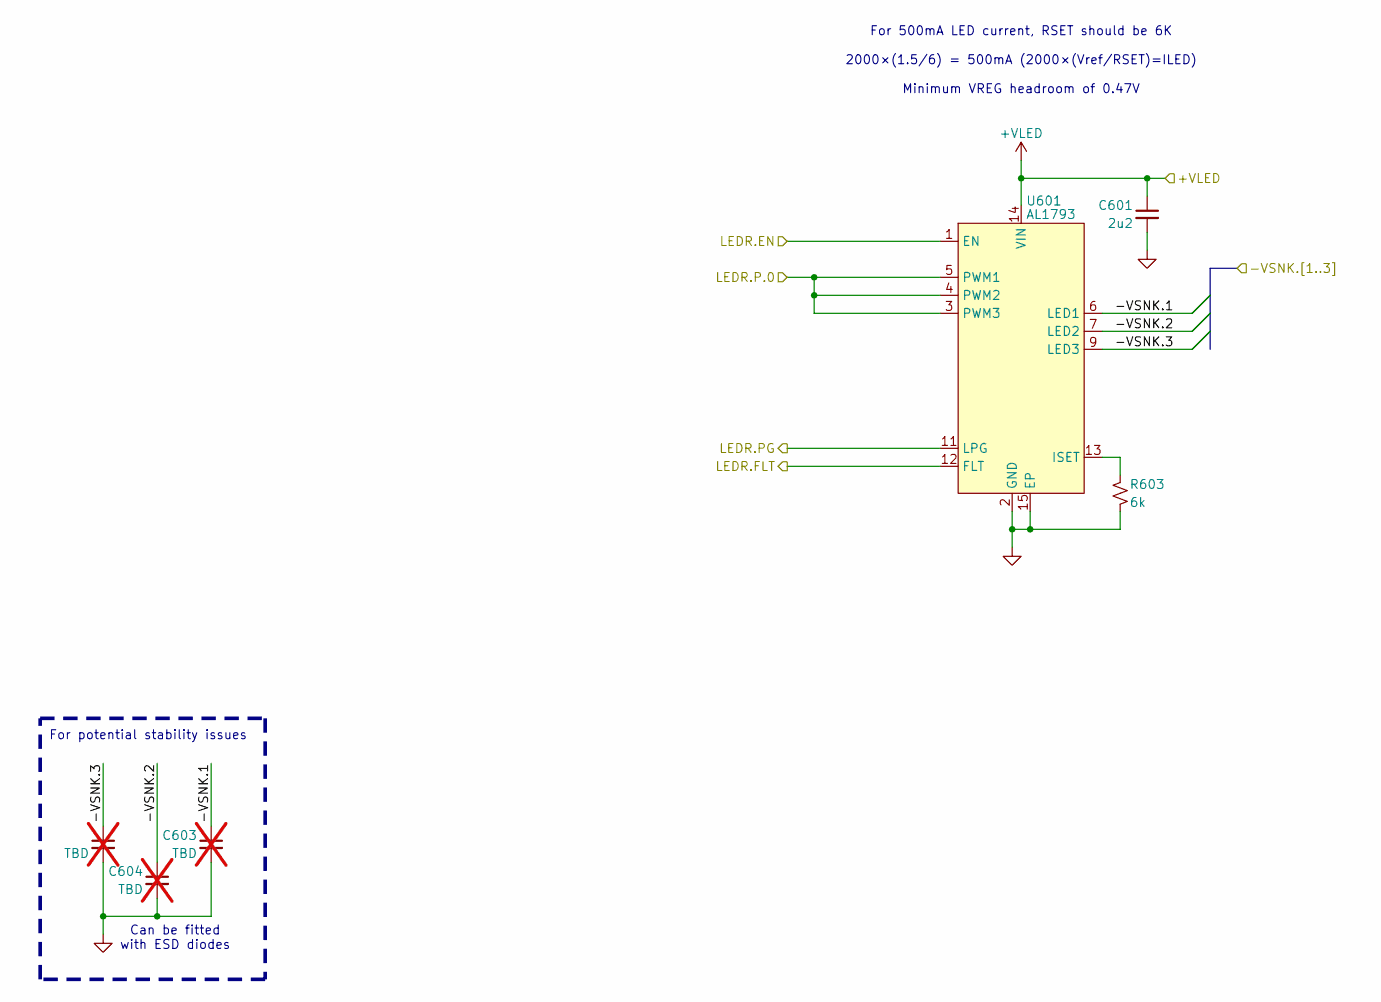
[picture p16: schematic LEDRED.kicad_sch, Growlight controller, red driver]

Parts:
C601: 2u2; C 0603 (1608 Metric)
C602, C603, C604: TBD; C 0402 (1005 Metric); not fitted
R603: 6k; R 0402 (1005 Metric)
U601: AL1793; UDFN4030-14 (3x4) 1EP

Connections:
+VLED: C601.1, U601.14 (VIN); also elsewhere on the board
/LED CONNECTORS/-VLEDR.1: C603.1, U601.6 (LED1); also elsewhere on the board
/LED CONNECTORS/-VLEDR.2: C604.1, U601.7 (LED2); also elsewhere on the board
/LED CONNECTORS/-VLEDR.3: C602.1, U601.9 (LED3); also elsewhere on the board
/LED DRIVERS/LED CW HIGH POWER/LEDHP.FLT1: U601.12 (FLT); also elsewhere on the board
/LED DRIVERS/LED CW HIGH POWER/LEDHP.PG1: U601.11 (LPG); also elsewhere on the board
/LED DRIVERS/LEDR.EN: U601.1 (EN); also elsewhere on the board
/LED DRIVERS/LEDR.P.0: U601.3 (PWM3), U601.4 (PWM2), U601.5 (PWM1); also elsewhere on the board
GND: C601.2, C602.2, C603.2, C604.2, R603.2, U601.2 (GND), U601.8 (GND), U601.10 (GND), U601.15 (EP); also elsewhere on the board
unnamed: R603.1, U601.13 (ISET)

Notes on the sheet:
For potential stability issues
Can be fitted with ESD diodes
For 500mA LED current, RSET should be 6K 2000×(1.5/6) = 500mA (2000×(Vref/RSET)=ILED) Minimum VREG headroom of 0.47V

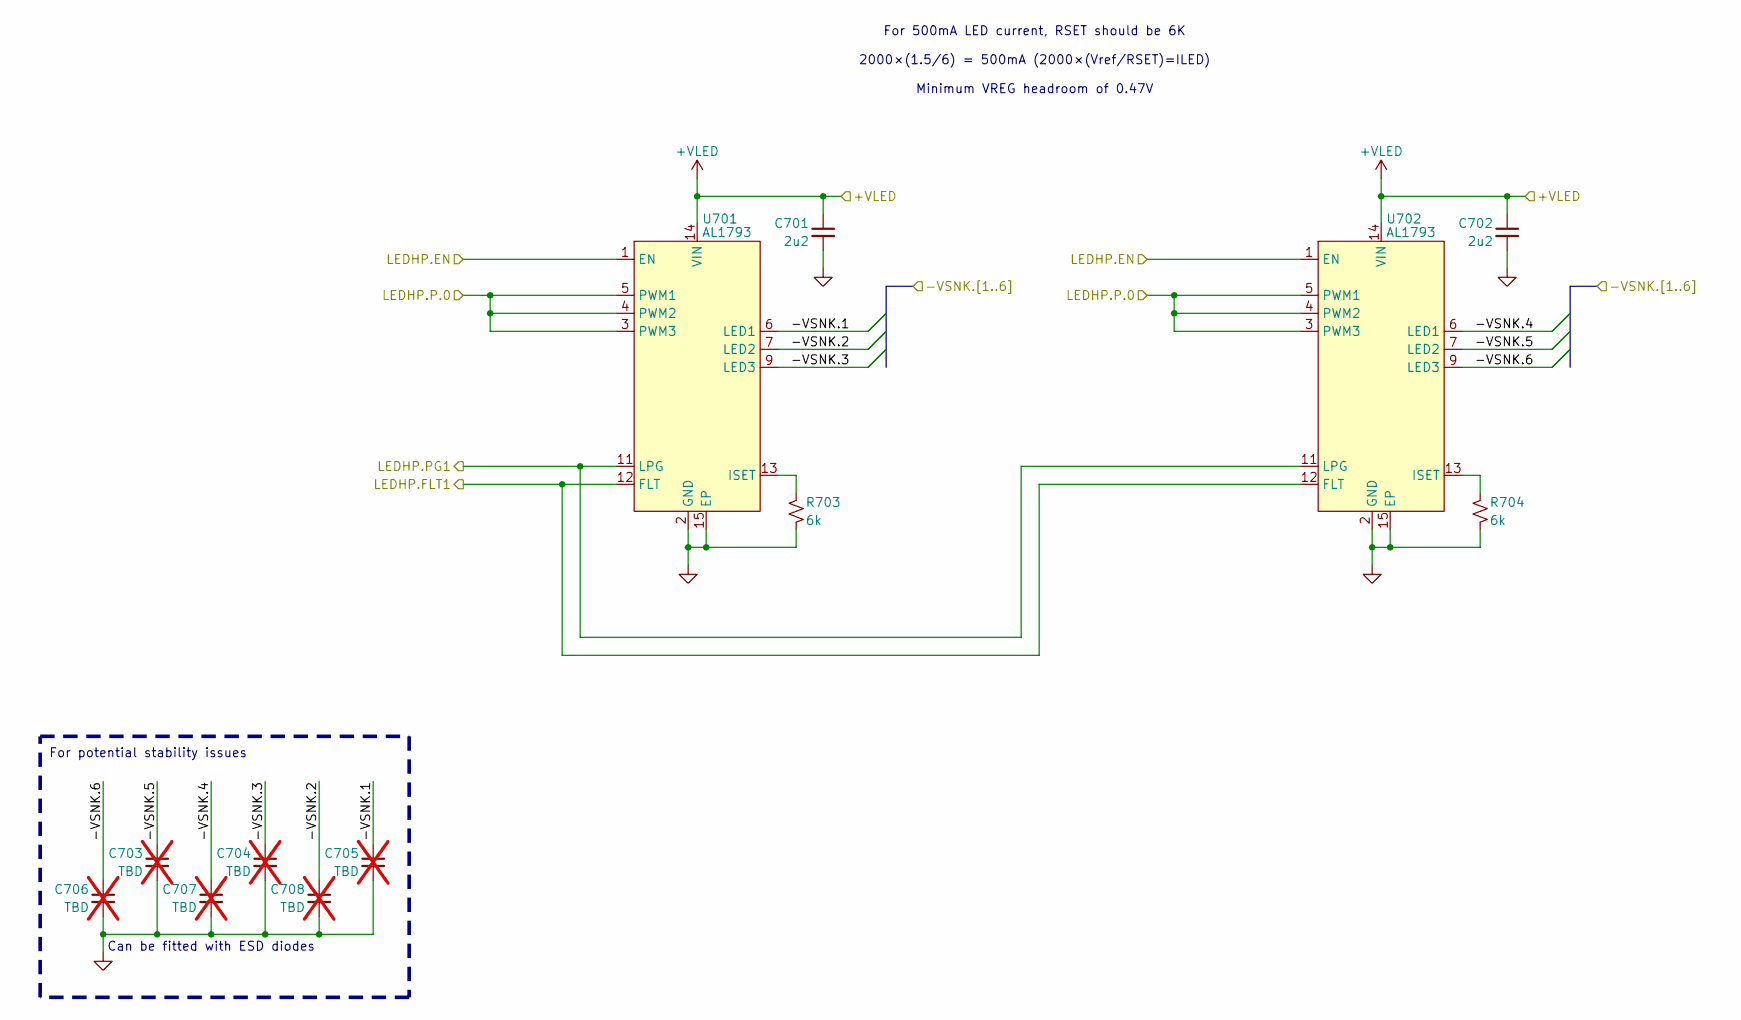
[picture p17: schematic LEDHP.kicad_sch, Growlight controller, cold white driver]

Parts:
C701, C702: 2u2; C 0603 (1608 Metric)
C703, C704, C705, C706, C707, C708: TBD; C 0402 (1005 Metric); not fitted
R703, R704: 6k; R 0402 (1005 Metric)
U701, U702: AL1793; UDFN4030-14 (3x4) 1EP

Connections:
+VLED: C701.1, C702.1, U701.14 (VIN), U702.14 (VIN); also elsewhere on the board
/LED CONNECTORS/-VLEDHP.1: C705.1, U701.6 (LED1); also elsewhere on the board
/LED CONNECTORS/-VLEDHP.2: C708.1, U701.7 (LED2); also elsewhere on the board
/LED CONNECTORS/-VLEDHP.3: C704.1, U701.9 (LED3); also elsewhere on the board
/LED CONNECTORS/-VLEDHP.4: C707.1, U702.6 (LED1); also elsewhere on the board
/LED CONNECTORS/-VLEDHP.5: C703.1, U702.7 (LED2); also elsewhere on the board
/LED CONNECTORS/-VLEDHP.6: C706.1, U702.9 (LED3); also elsewhere on the board
/LED DRIVERS/LED CW HIGH POWER/LEDHP.FLT1: U701.12 (FLT), U702.12 (FLT); also elsewhere on the board
/LED DRIVERS/LED CW HIGH POWER/LEDHP.PG1: U701.11 (LPG), U702.11 (LPG); also elsewhere on the board
/LED DRIVERS/LEDHP.EN: U701.1 (EN), U702.1 (EN); also elsewhere on the board
/LED DRIVERS/LEDHP.P.0: U701.3 (PWM3), U701.4 (PWM2), U701.5 (PWM1), U702.3 (PWM3), U702.4 (PWM2), U702.5 (PWM1); also elsewhere on the board
GND: C701.2, C702.2, C703.2, C704.2, C705.2, C706.2, C707.2, C708.2, R703.2, R704.2, U701.2 (GND), U701.8 (GND), U701.10 (GND), U701.15 (EP), U702.2 (GND), U702.8 (GND), U702.10 (GND), U702.15 (EP); also elsewhere on the board
unnamed: R703.1, U701.13 (ISET)
unnamed: R704.1, U702.13 (ISET)

Notes on the sheet:
Can be fitted with ESD diodes
For 500mA LED current, RSET should be 6K 2000×(1.5/6) = 500mA (2000×(Vref/RSET)=ILED) Minimum VREG headroom of 0.47V
For potential stability issues
