Eliiiiiiiiiiii/Growlight-controller/Controller.kicad_pcb

## KiCad design Controller.kicad_pcb (continued)

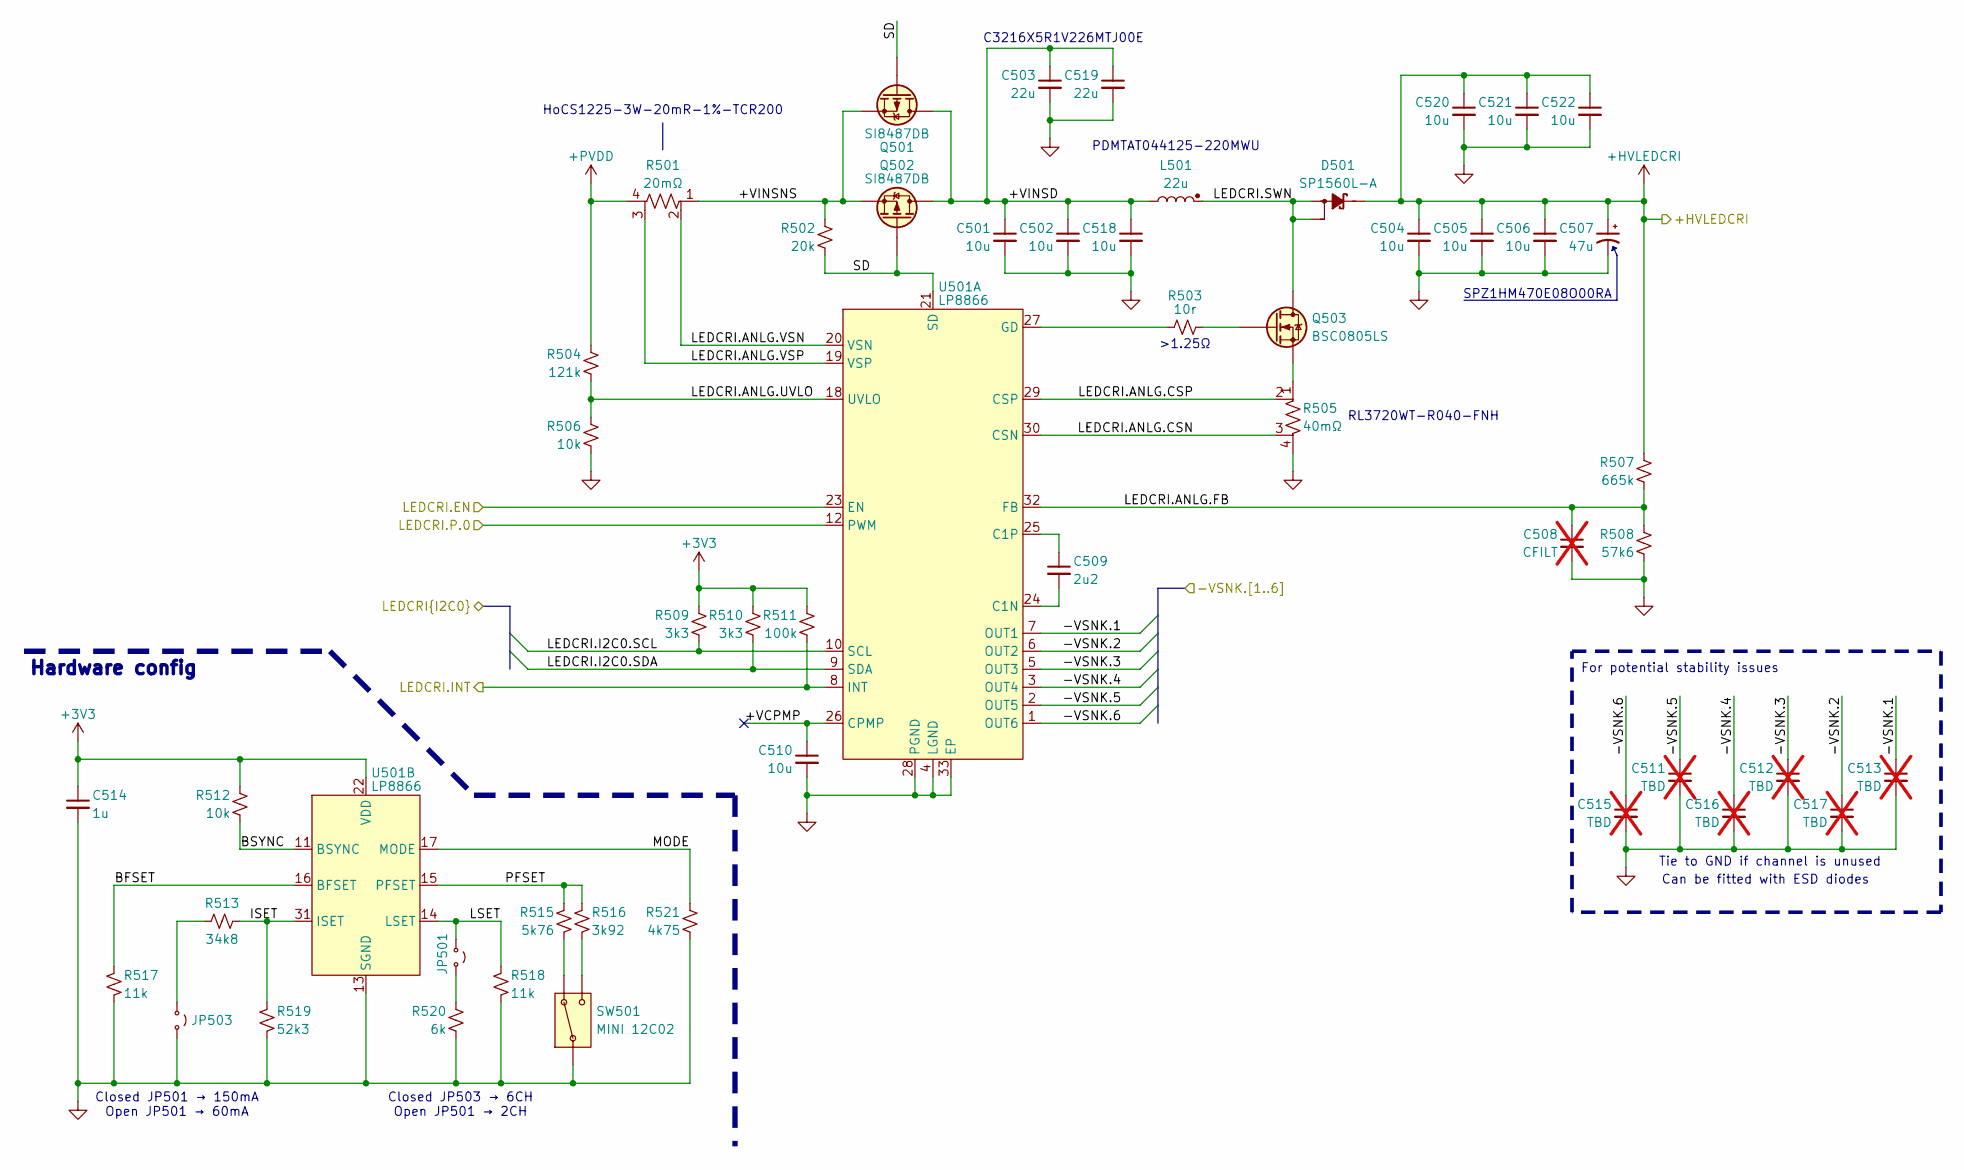
[picture p18: schematic LEDCRI.kicad_sch, Growlight controller, warm white driver]

Parts:
C501, C502, C504, C505, C506, C510, C518, C520, C521, C522: 10u; C 0805 (2012 Metric)
C503, C519: 22u; C_1206_3216Metric
C507: 47u; CP_Radial_D6.3mm_P2.50mm
C508: CFILT; C 0402 (1005 Metric); not fitted
C509: 2u2; C 0603 (1608 Metric)
C511, C512, C513, C515, C516, C517: TBD; C 0402 (1005 Metric); not fitted
C514: 1u; C 0402 (1005 Metric)
D501: SP1560L-A; TO-227B Dowo
JP501: Jumper_2_Small_Open; Jumper-NO 2P (1.9x1.4)
JP503: Jumper_2_Small_Open; PinHeader_1x02_P1.00mm_Vertical
L501: 22u; PDMTAT044125-220MWU
Q501, Q502: SI8487DB; WLCSP-4 (1.56x1.56) P0.8
Q503: BSC0805LS; DFN-8 (5x6) 1EP Infineon
R501: 20mΩ; R 1225 2w Kelvin
R502: 20k; R 0402 (1005 Metric)
R503: 10r; R 0603 (1608 Metric)
R504: 121k; R 0402 (1005 Metric)
R505: 40mΩ; R 1508 2w Kelvin
R506, R512: 10k; R 0402 (1005 Metric)
R507: 665k; R 0603 (1608 Metric)
R508: 57k6; R 0402 (1005 Metric)
R509, R510: 3k3; R 0402 (1005 Metric)
R511: 100k; R 0402 (1005 Metric)
R513: 34k8; R 0402 (1005 Metric)
R515: 5k76; R 0402 (1005 Metric)
R516: 3k92; R 0402 (1005 Metric)
R517, R518: 11k; R 0402 (1005 Metric)
R519: 52k3; R 0402 (1005 Metric)
R520: 6k; R 0402 (1005 Metric)
R521: 4k75; R 0402 (1005 Metric)
SW501: MINI 12C02; MINI MSK12CO2
U501: LP8866; QFN-32 (5x5) P0.5

Connections:
+3V3: C514.1, R509.1, R510.1, R511.1, R512.1, U501.22 (VDD); also elsewhere on the board
+HVLEDCRI: C504.1, C505.1, C506.1, C507.1, C520.1, C521.1, C522.1, D501.3 (K), R507.1; also elsewhere on the board
+PVDD: R501.4, R504.1; also elsewhere on the board
/LED CONNECTORS/-VLEDCRI.1: C513.1, U501.7 (OUT1); also elsewhere on the board
/LED CONNECTORS/-VLEDCRI.2: C517.1, U501.6 (OUT2); also elsewhere on the board
/LED CONNECTORS/-VLEDCRI.3: C512.1, U501.5 (OUT3); also elsewhere on the board
/LED CONNECTORS/-VLEDCRI.4: C516.1, U501.3 (OUT4); also elsewhere on the board
/LED CONNECTORS/-VLEDCRI.5: C511.1, U501.2 (OUT5); also elsewhere on the board
/LED CONNECTORS/-VLEDCRI.6: C515.1, U501.1 (OUT6); also elsewhere on the board
/LED DRIVERS/LED WW HIGH CRI/+VCPMP: C510.1, U501.26 (CPMP)
/LED DRIVERS/LED WW HIGH CRI/+VINSD: C501.1, C502.1, C503.1, C518.1, C519.1, L501.2, Q501.2 (D), Q501.3 (D), Q502.2 (D), Q502.3 (D)
/LED DRIVERS/LED WW HIGH CRI/+VINSNS: Q501.4 (S), Q502.4 (S), R501.1, R502.1
/LED DRIVERS/LED WW HIGH CRI/BFSET: R517.1, U501.16 (BFSET)
/LED DRIVERS/LED WW HIGH CRI/BSYNC: R512.2, U501.11 (BSYNC)
/LED DRIVERS/LED WW HIGH CRI/ISET: R513.2, R519.1, U501.31 (ISET)
/LED DRIVERS/LED WW HIGH CRI/LEDCRI.ANLG.CSN: R505.3, U501.30 (CSN)
/LED DRIVERS/LED WW HIGH CRI/LEDCRI.ANLG.CSP: R505.2, U501.29 (CSP)
/LED DRIVERS/LED WW HIGH CRI/LEDCRI.ANLG.FB: C508.1, R507.2, R508.1, U501.32 (FB)
/LED DRIVERS/LED WW HIGH CRI/LEDCRI.ANLG.UVLO: R504.2, R506.1, U501.18 (UVLO)
/LED DRIVERS/LED WW HIGH CRI/LEDCRI.ANLG.VSN: R501.2, U501.20 (VSN)
/LED DRIVERS/LED WW HIGH CRI/LEDCRI.ANLG.VSP: R501.3, U501.19 (VSP)
/LED DRIVERS/LED WW HIGH CRI/LEDCRI.SWN: D501.1 (A), D501.2 (A), L501.1, Q503.5 (D)
/LED DRIVERS/LED WW HIGH CRI/LSET: JP501.2 (B), R518.1, U501.14 (LSET)
/LED DRIVERS/LED WW HIGH CRI/MODE: R521.1, U501.17 (MODE)
/LED DRIVERS/LED WW HIGH CRI/PFSET: R515.1, R516.1, U501.15 (PFSET)
/LED DRIVERS/LED WW HIGH CRI/SD: Q501.1 (G), Q502.1 (G), R502.2, U501.21 (SD)
/LED DRIVERS/LEDCRI.EN: U501.23 (EN); also elsewhere on the board
/LED DRIVERS/LEDCRI.I2C0.SCL: R509.2, U501.10 (SCL); also elsewhere on the board
/LED DRIVERS/LEDCRI.I2C0.SDA: R510.2, U501.9 (SDA); also elsewhere on the board
/LED DRIVERS/LEDCRI.INT: R511.2, U501.8 (INT); also elsewhere on the board
/LED DRIVERS/LEDCRI.P.0: U501.12 (PWM); also elsewhere on the board
GND: C501.2, C502.2, C503.2, C504.2, C505.2, C506.2, C507.2, C508.2, C510.2, C511.2, C512.2, C513.2, C514.2, C515.2, C516.2, C517.2, C518.2, C519.2, C520.2, C521.2, C522.2, JP503.1 (A), R505.4, R506.2, R508.2, R517.2, R518.2, R519.2, R520.2, R521.2, SW501.2 (COM), U501.4 (LGND), U501.13 (SGND), U501.28 (PGND), U501.33 (EP); also elsewhere on the board
unnamed: JP501.1 (A), R520.1
unnamed: JP503.2 (B), R513.1
unnamed: Q503.4 (G), R503.2
unnamed: Q503.1 (S), Q503.2 (S), Q503.3 (S), R505.1
unnamed: R515.2, SW501.1 (C1)
unnamed: R516.2, SW501.3 (C2)
unnamed: C509.2, U501.24 (C1N)
unnamed: C509.1, U501.25 (C1P)
unnamed: R503.1, U501.27 (GD)

Notes on the sheet:
>1.25Ω
SPZ1HM470E08O00RA
RL3720WT-R040-FNH
For potential stability issues
Closed JP501 → 150mA Open JP501 → 60mA
Closed JP503 → 6CH Open JP501 → 2CH
PDMTAT044125-220MWU
Tie to GND if channel is unused
C3216X5R1V226MTJ00E
Hardware config
HoCS1225-3W-20mR-1%-TCR200
Can be fitted with ESD diodes

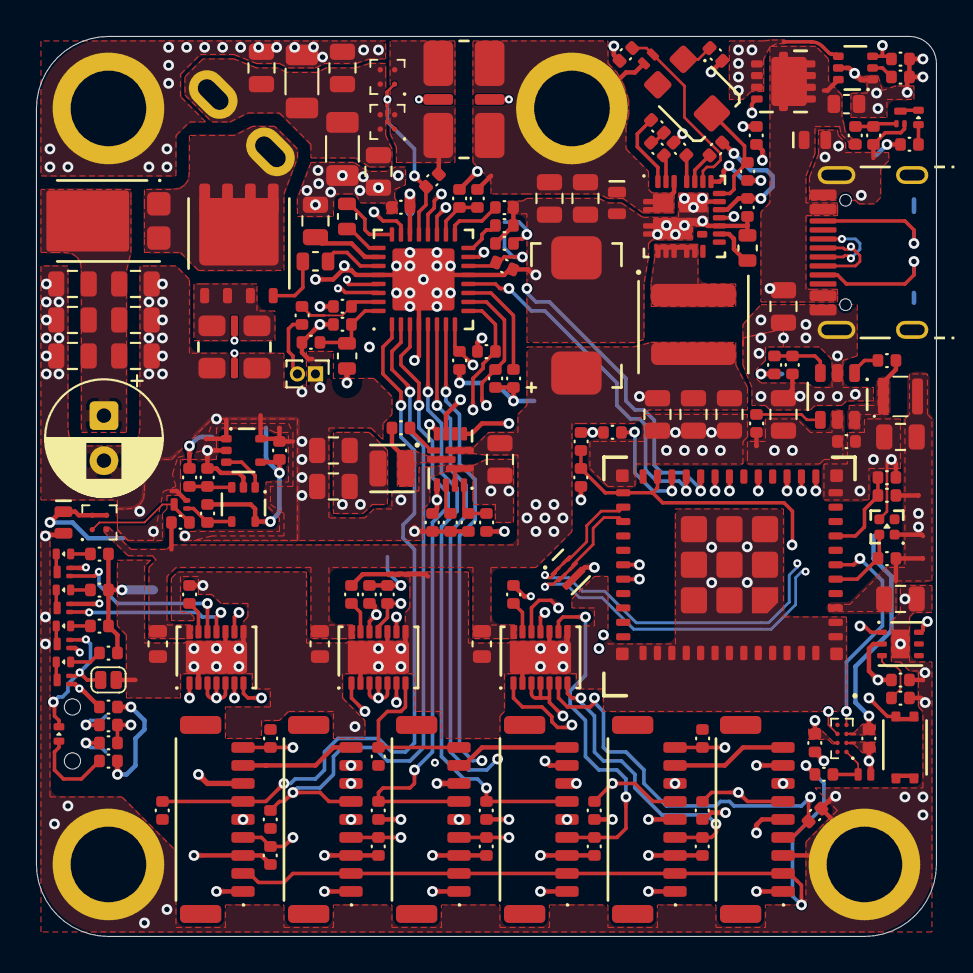
[picture p19: board Controller.kicad_pcb from above]

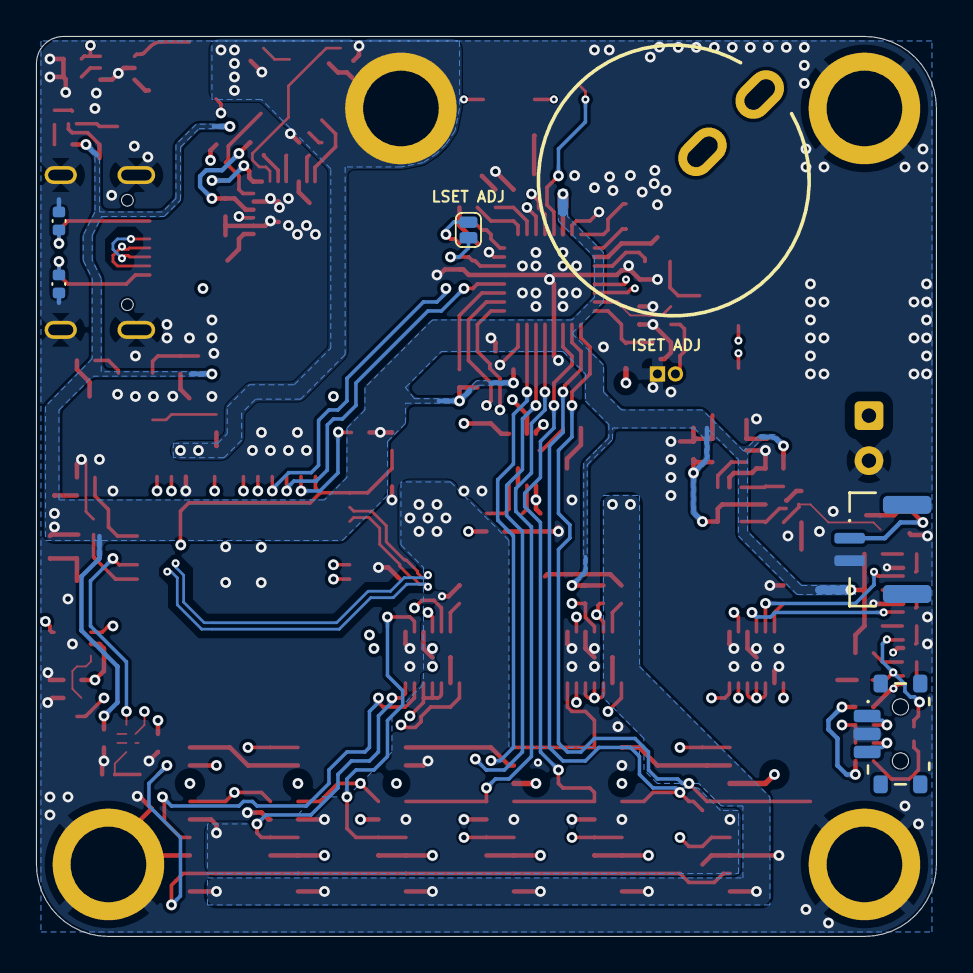
[picture p20: board Controller.kicad_pcb from below]

Board: 6 copper layers, 50.0 x 50.0 mm, 182 parts (6 on the bottom side), 119 nets.
